IowaScaledEngineering/mrb-fcm/mech/frame/20130630_171943.jpg

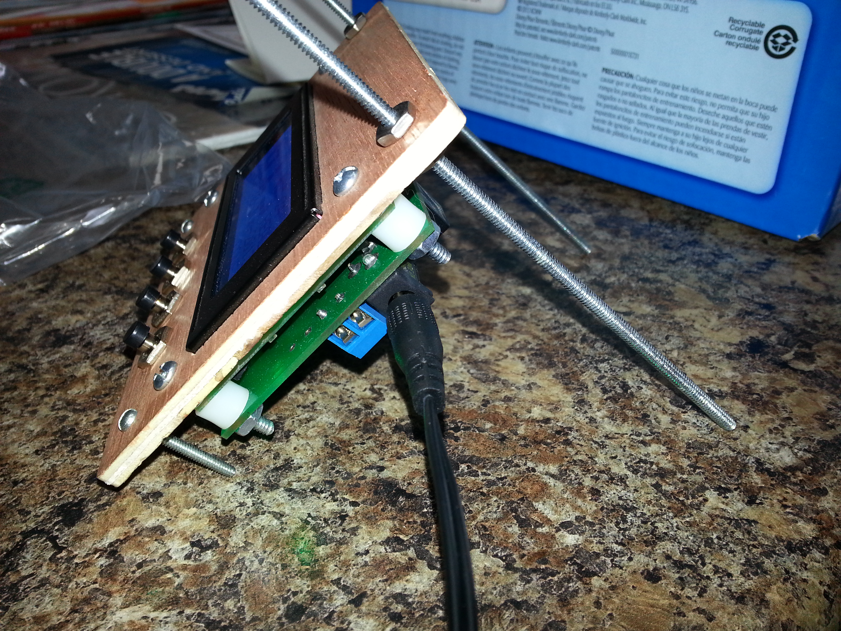
mech/frame/20130630_171943.jpg
