IowaScaledEngineering/mrb-fcm/doc/fastclock-bag-top-landscape.odt

Iowa Scaled Engineering, LLC

http://iascaled.com/

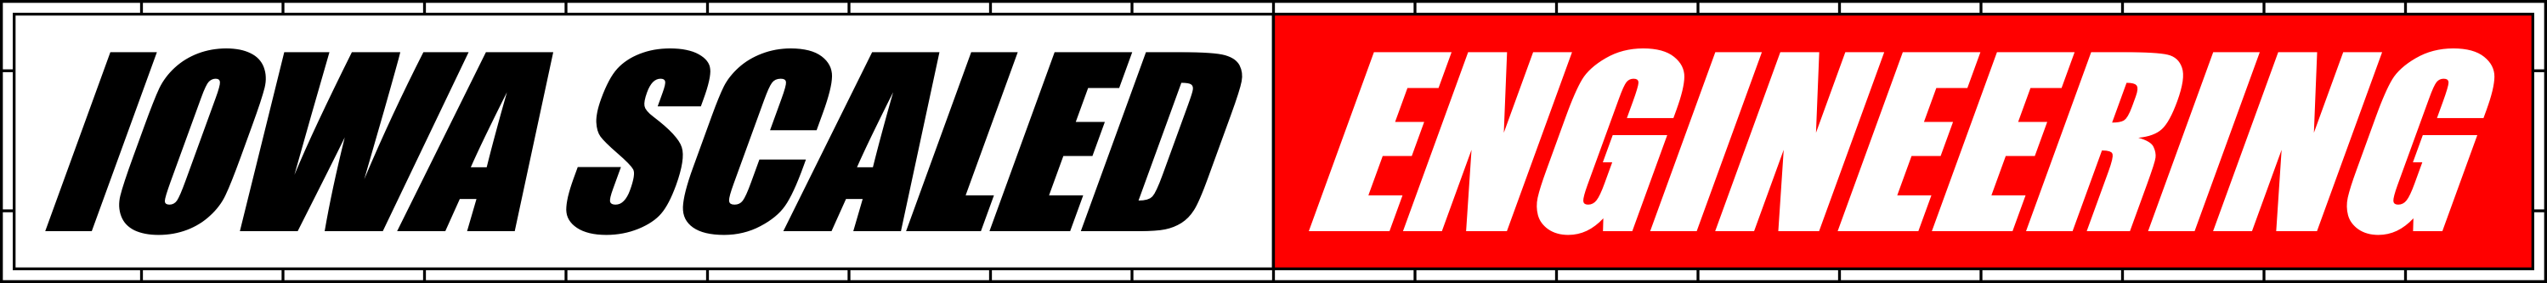
[picture p2: figure]

Fast Clock Master

Fast clock featuring fast time ratios from 1:1 to 99:1, three configurable start times, 12 or 24 hour display formats, "Hold" mode, unlimited remote displays, and real or fast time modes.

Wireless Version w/Extended-Range Radio

MRBW-FCM
