IowaScaledEngineering/mrb-fcm/doc/fastclock-bag-top.odt

Iowa Scaled Engineering, LLC

http://iascaled.com/

Iowa Scaled Engineering, LLC

http://iascaled.com/

Fast Clock Master

Fast clock featuring fast time ratios from 1:1 to 99:1, three configurable start times, 12 or 24 hour display formats, "Hold" mode, unlimited remote displays, and real or fast time modes.

Wireless Version

MRBW-FCM

Fast Clock Secondary Display

Fast time display shows the current fast or real time in multiple strategic locations around the layout room, all automatically synchronized to the master clock.

Wireless Version

MRBW-FCS

Fast Clock Master

Fast clock featuring fast time ratios from 1:1 to 99:1, three configurable start times, 12 or 24 hour display formats, "Hold" mode, unlimited remote displays, and real or fast time modes.

Wireless Version w/Extended-Range Radio

$138

STL RPM SALE!

Includes FREE face plate and power supply.

MRBW-FCM

Fast Clock Secondary Display

Fast time display shows the current fast or real time in multiple strategic locations around the layout room, all automatically synchronized to the master clock.

Wireless Version

$75

STL RPM SALE!

Includes FREE face plate and power supply.

MRBW-FCS
