IowaScaledEngineering/mrb-fcm/pg/mrb-fcm-sw-v1.0-r1073/mrb-fcm-sw-pcb.pdf

# mrb-fcm-sw.pcb

# 1. Table of Contents (This Page) Created on Mon May 26 17:38:17 2014

# 2. top 3. bottom 4. outline 5. plated-drill 6. componentmask 7. soldermask 8. topsilk 9. bottomsilk 10. topassembly 11. bottomassembly 12. fab

top, scale = 1:1.000 bottom (mirrored), scale = 1:1.000

outline, scale = 1:1.000 plated-drill, scale = 1:1.000

topmask, scale = 1:1.000 bottommask (mirrored), scale = 1:1.000

topsilk, scale = 1:1.000 bottomsilk (mirrored), scale = 1:1.000

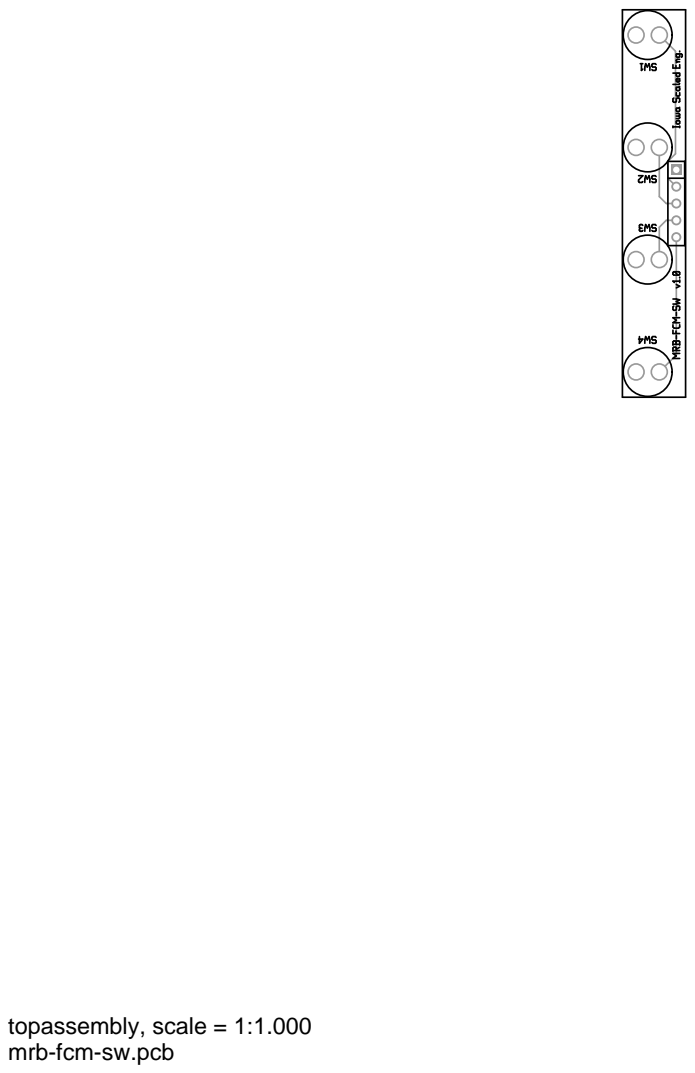
[picture p3: page 10]
topassembly, scale = 1:1.000

bottomassembly (mirrored), scale = 1:1.000

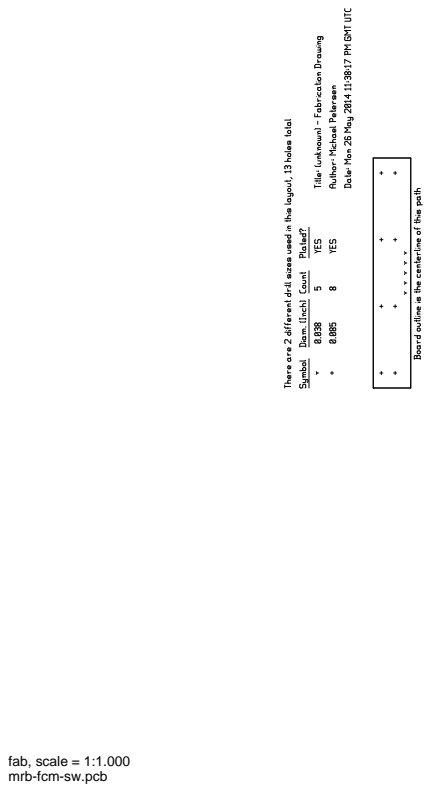
[picture p4: page 12]
fab, scale = 1:1.000
