IowaScaledEngineering/mrb-fcm/mech/faceplates/fcm-template.pdf

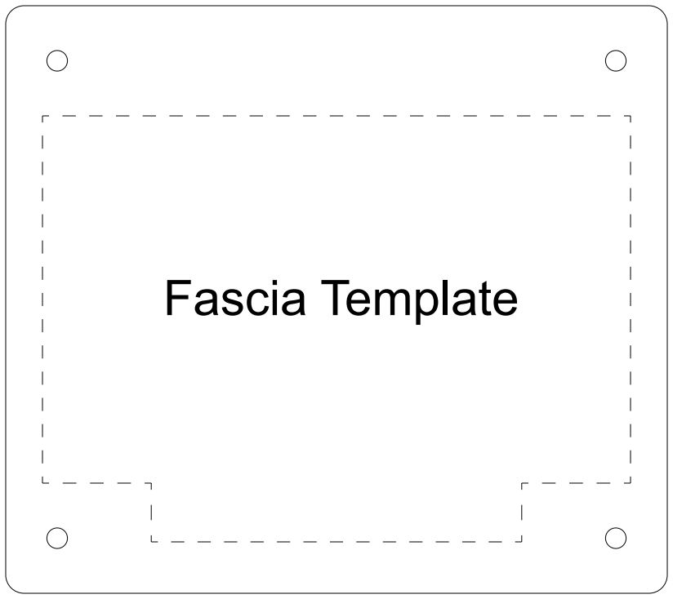
[picture p5: figure]
Fascia Template
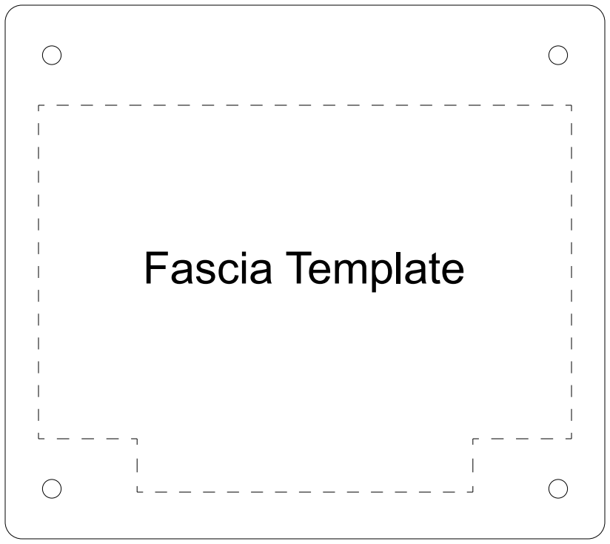
[picture p6: figure]
Fascia Template
