IowaScaledEngineering/mrb-fcm/doc/datasheets/erm2004-1_outline.jpg

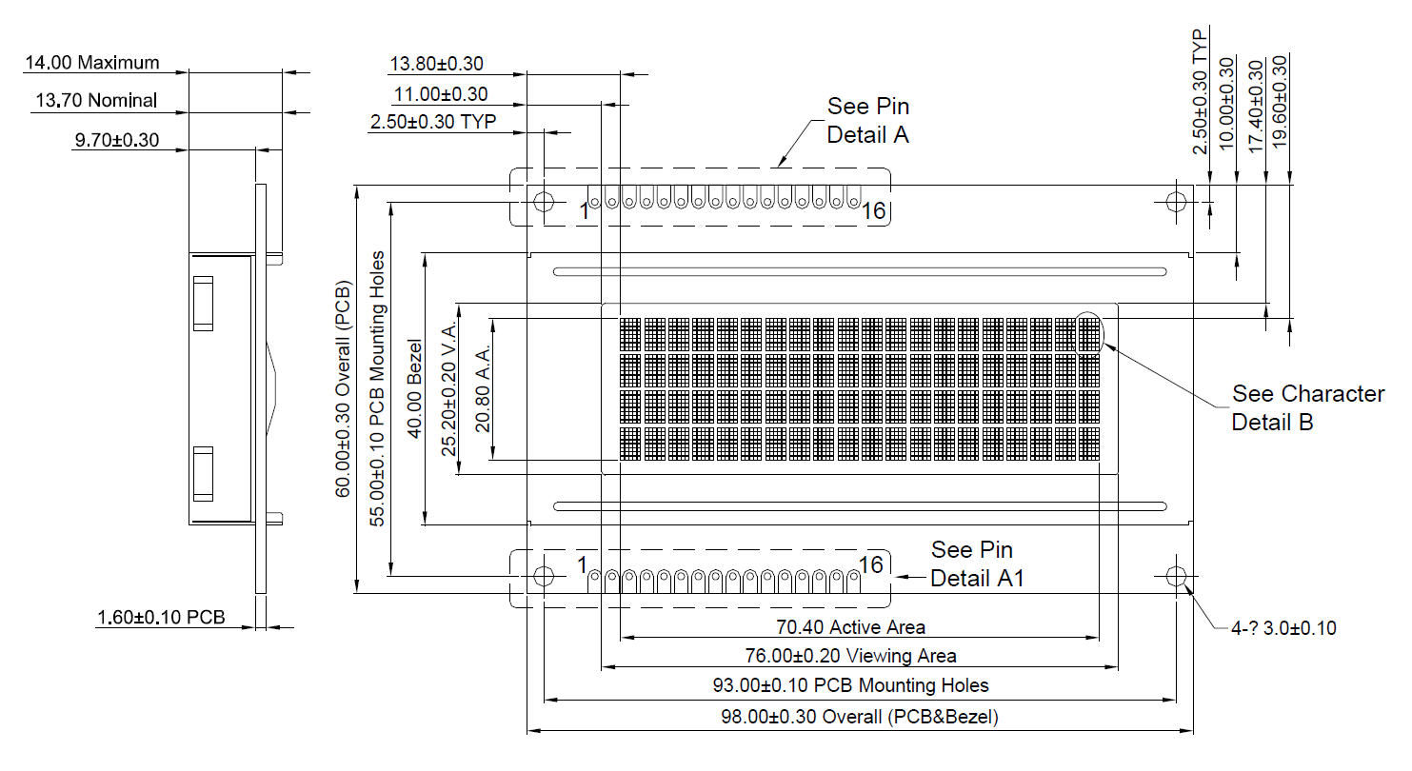
doc/datasheets/erm2004-1_outline.jpg
