IowaScaledEngineering/mrb-fcm/mech/box/fcm-box-open.stl

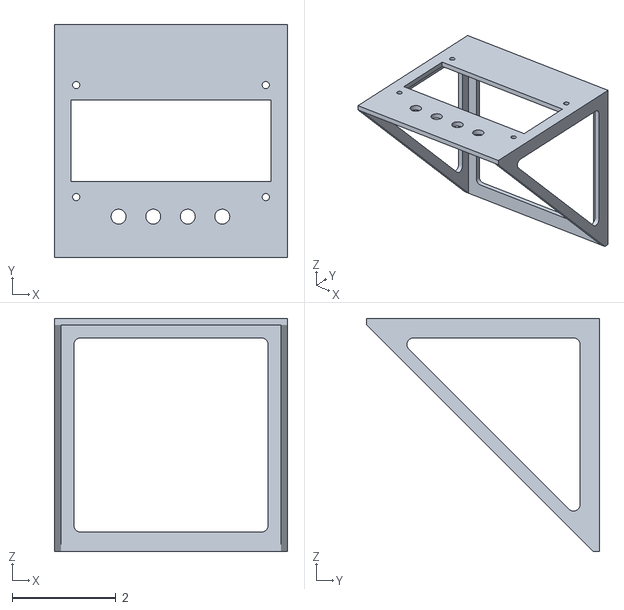
[picture p8: CAD file, 2013-11-04]
mech/box/fcm-box-open.stl
4.50 x 4.50 x 4.50
