IowaScaledEngineering/mrb-fcm/mech/faceplates/fcm-faceplate2-spacer.stl

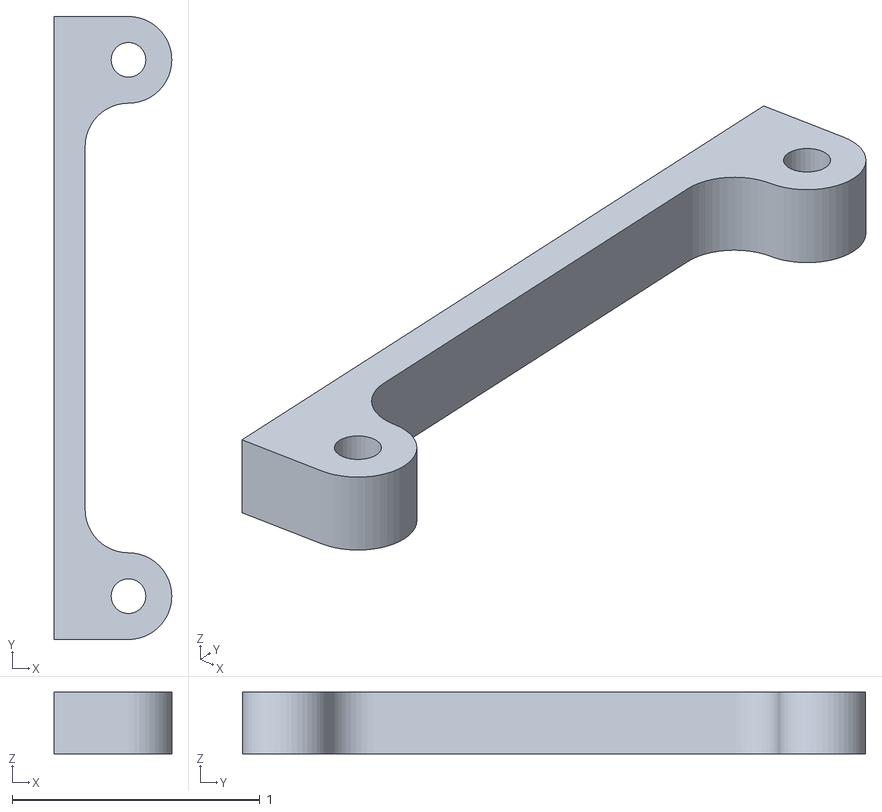
[picture p9: CAD file, 2026-06-20]
mech/faceplates/fcm-faceplate2-spacer.stl
0.475 x 2.52 x 0.25
