IowaScaledEngineering/mrb-fcm/mech/faceplates/v1/FCM Faceplate.stl

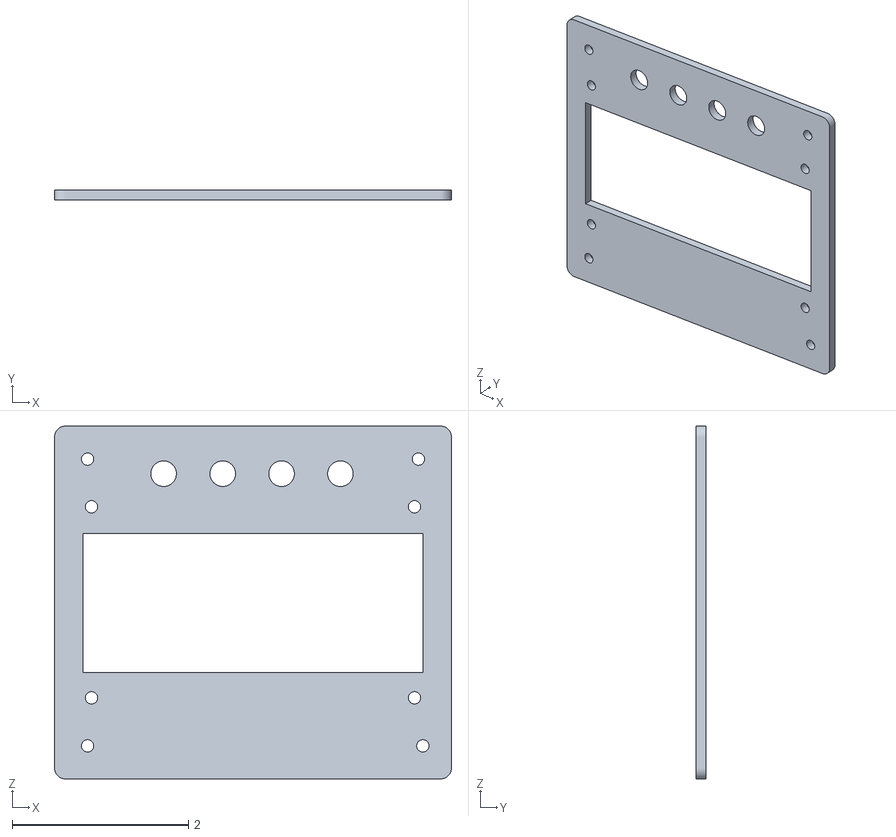
[picture p10: CAD file, 2019-03-28]
mech/faceplates/v1/FCM Faceplate.stl
4.50 x 0.118 x 4.00
