IowaScaledEngineering/mrb-fcm/mech/box/fcm-box.stl

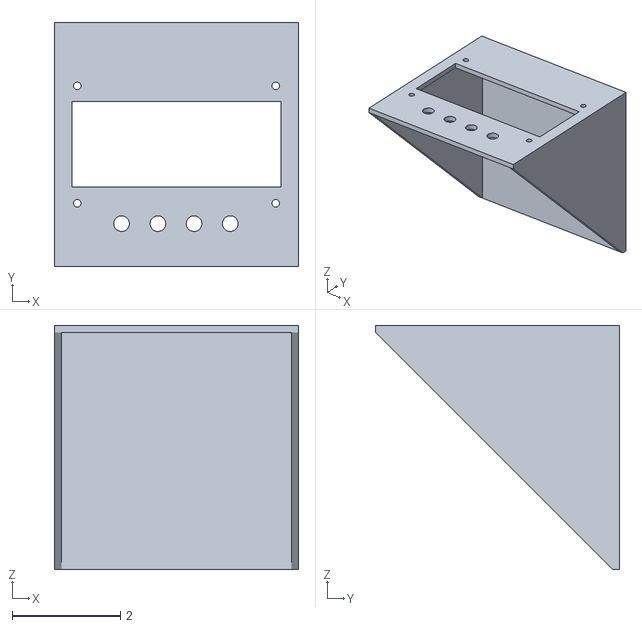
[picture p11: CAD file, 2013-11-04]
mech/box/fcm-box.stl
4.50 x 4.50 x 4.50
