IowaScaledEngineering/mrb-fcm/mech/faceplates/lcd-spacer.stl

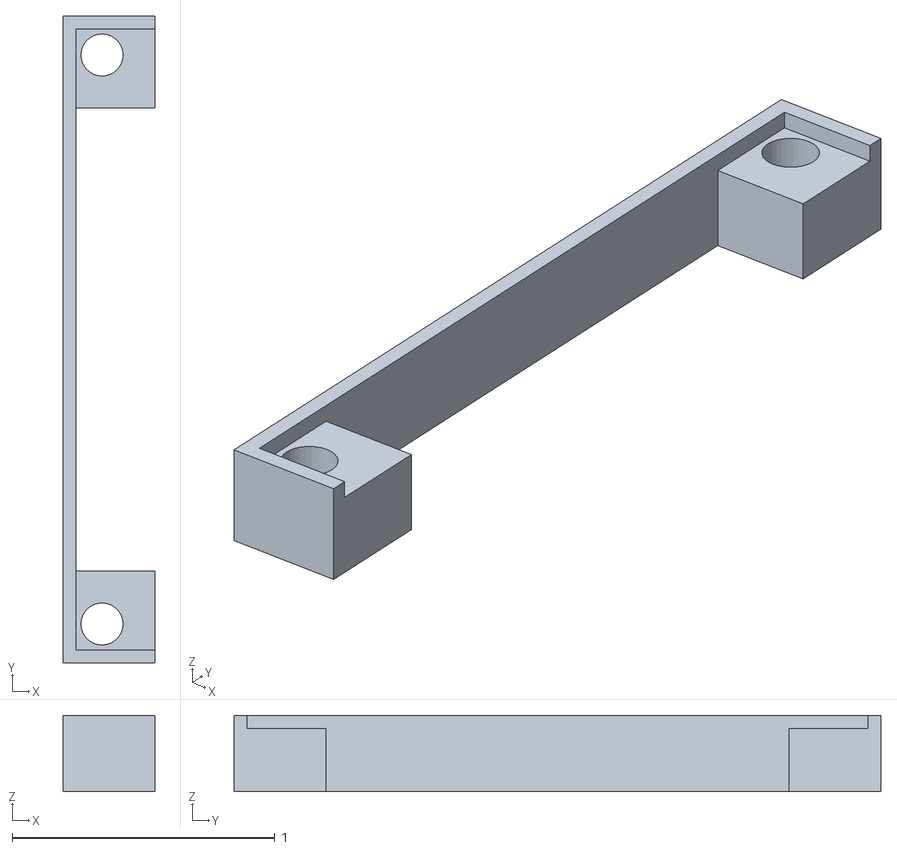
[picture p12: CAD file, 2026-06-20]
mech/faceplates/lcd-spacer.stl
0.35 x 2.46 x 0.29
