IowaScaledEngineering/mrb-fcm/mech/faceplates/v1/Display-Dimensions.dxf

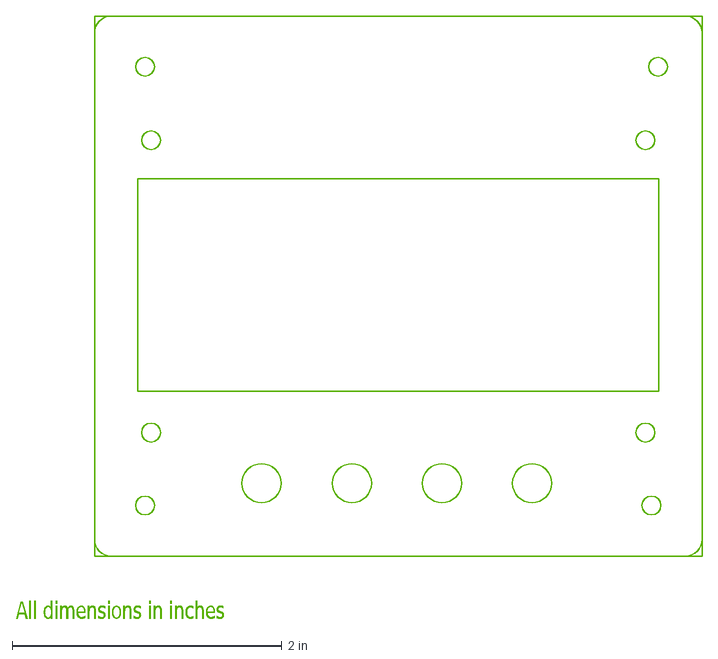
[picture p13: CAD file, 2014-01-10]
mech/faceplates/v1/Display-Dimensions.dxf
All dimensions in inches
