IowaScaledEngineering/mrb-fcm/mech/faceplates/fcm-faceplate v11.stl

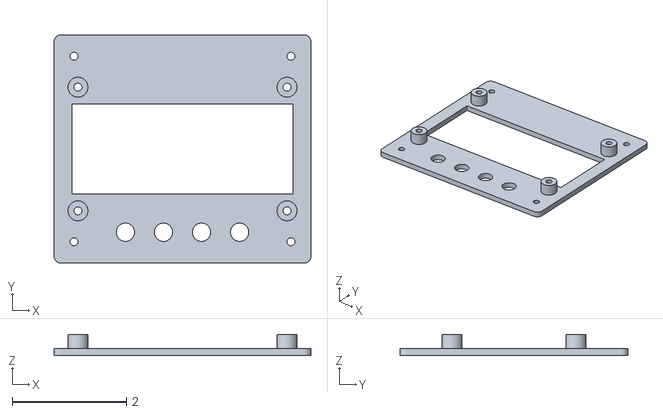
[picture p14: CAD file, 2021-11-19]
mech/faceplates/fcm-faceplate v11.stl
4.50 x 4.00 x 0.37
