IowaScaledEngineering/mrb-fcm/mech/faceplates/v1/Display.dxf

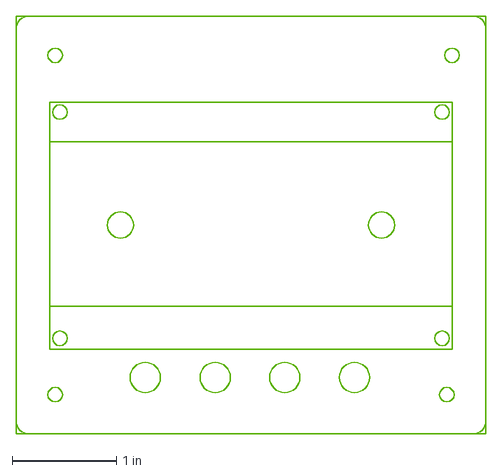
[picture p15: CAD file, 2014-01-10]
mech/faceplates/v1/Display.dxf
4.50 x 4.00 in
