IowaScaledEngineering/mrb-fcm/mech/faceplates/fcm-table-mount v6.stl

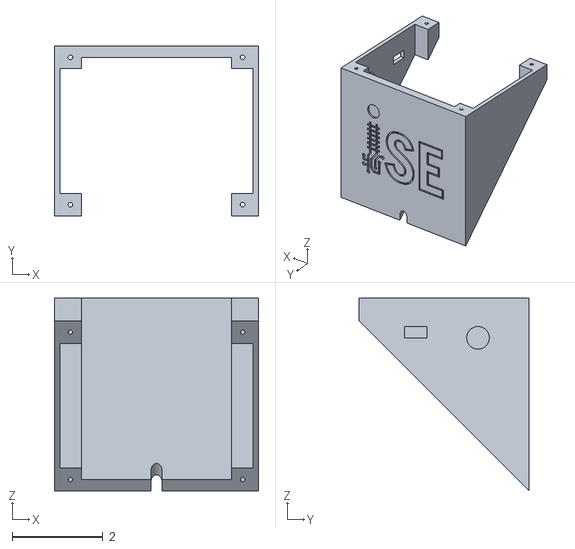
[picture p16: CAD file, 2021-07-27]
mech/faceplates/fcm-table-mount v6.stl
4.50 x 3.75 x 4.25
