IowaScaledEngineering/mrb-fcm/mech/faceplates/fcm-spacer v3.stl

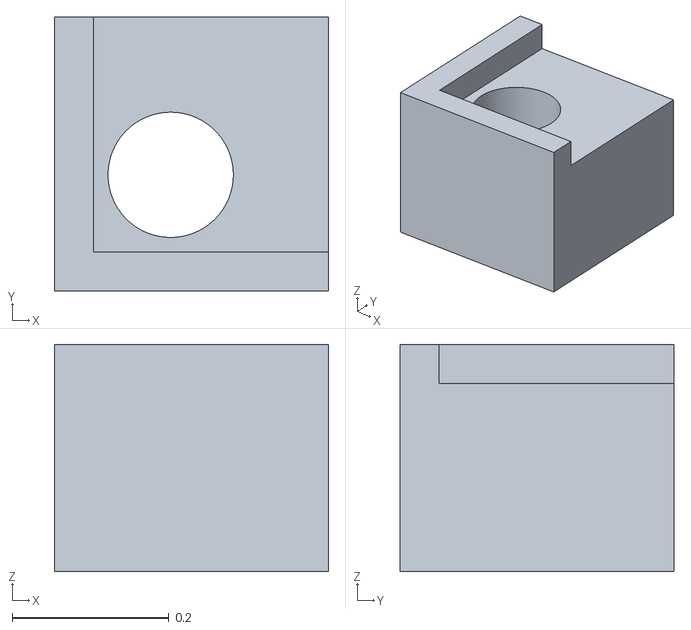
[picture p17: CAD file, 2020-11-19]
mech/faceplates/fcm-spacer v3.stl
0.35 x 0.35 x 0.29
