IowaScaledEngineering/mrb-fcm/(list of files, cad)

Other CAD files:
mech/box/fcm-box-open-repaired.stl
mech/box/fcm-box.scad
mech/faceplates/v1/FCM Faceplate.f3d
