IowaScaledEngineering/mrb-fcm/doc/fastclockmanual.odt

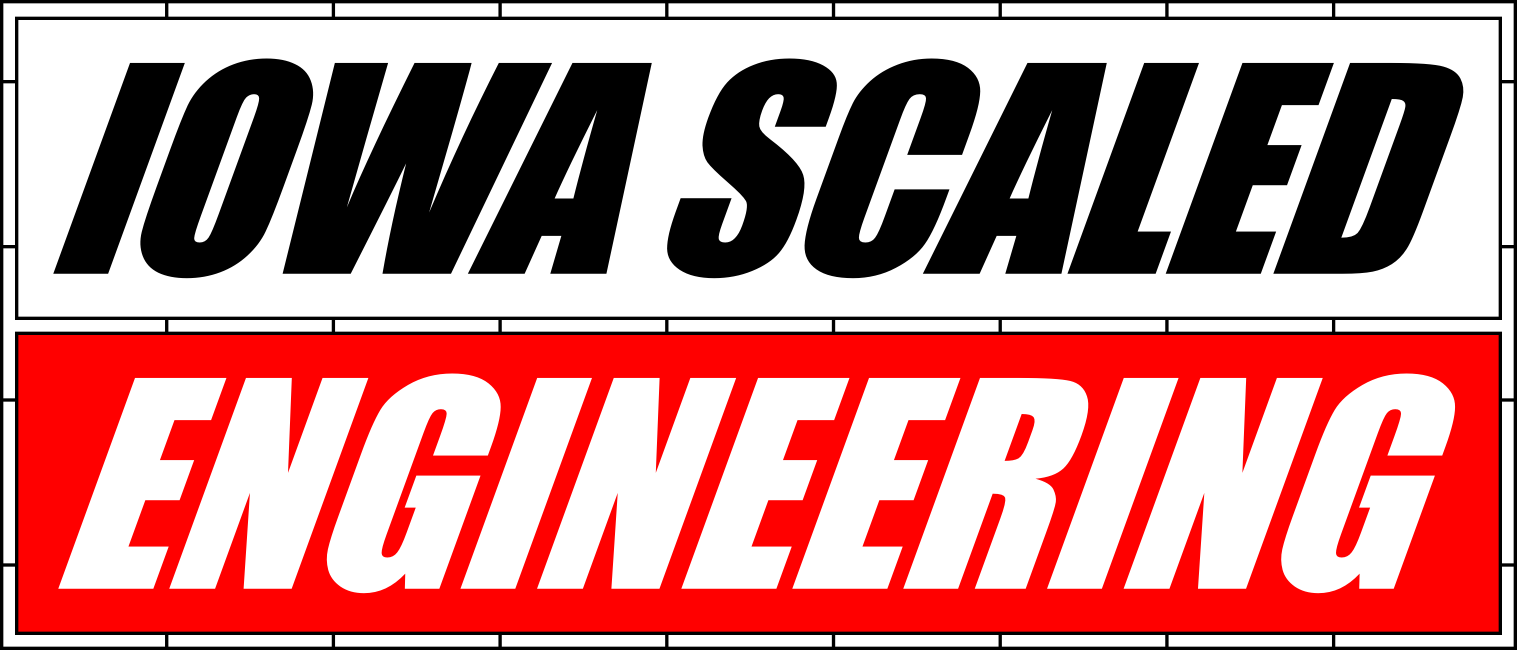
[picture p18: figure]

PaceSetter
Wireless Scale Time Clock

Instruction Manual

MRB-FCM v2.1

The PaceSetter is a configurable digital scale time clock designed to support timetable-based model railroad operations.

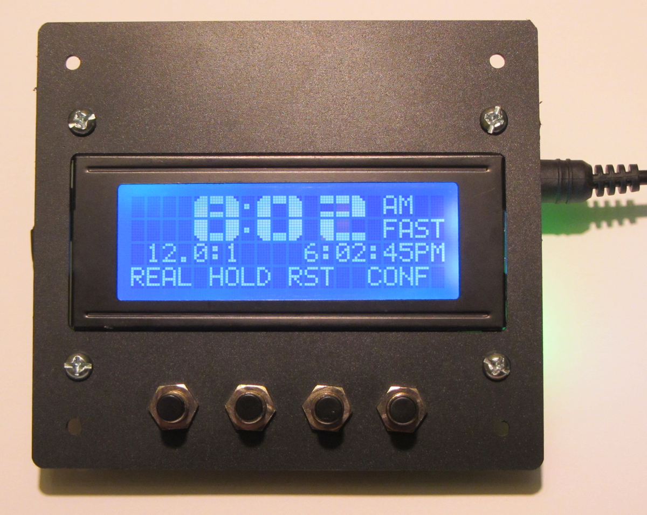
[picture p19: figure]
An MRB-FCM clock with optional faceplate and buttons, displaying fast time

## Key Features

- Scale time clock ratio adjustable between 0.1:1 and 99.9:1 for running faster or slower than real time
- “Hold” mode for pausing operations
- Switchable display between fast and real time
- Real-time clock/calendar with battery backup
- Three configurable fast clock start times
- 12 and 24 hour time display formats
- Compatible with wireless PaceSetter Remote Displays
- Compatible with the ProtoThrottle

## Kit Contents

- PaceSetter master fast clock
- 12V 1A power supply
- Faceplate (pre-installed)
- Manual and fascia cutting template

## Installation

The PaceSetter requires a stable 8-24V DC power supply capable of 0.3 amps. The kit includes a 12V power supply that can be plugged directly into J1A on the back, or if your layout has DC power already available, it can be connected to terminal block J1 instead.

The PaceSetter is designed to be mounted in the layout fascia. To help you accurately position and cut the necessary holes, we’ve included a template for the cutout.

## About “Fast” Time

The PaceSetter is a scale time clock, meaning that you can run “fast” time both faster or slower than real time. Most users will use it to run faster, meaning that several minutes of scale time will pass for each real minute (ratios greater than 1.0:1), but some users may also want to run slower, such that a scale minute takes 2-3 real minutes (ratios less than 1.0:1). It’s up to you. However, in the manual and the menus, this scaled time will be referred to as “fast” regardless.

## Initial Configuration

The PaceSetter comes from Iowa Scaled preprogrammed with reasonable defaults, so for many users the only initial configuration needed will be the current date and time, as well as fast clock parameters appropriate for your layout. All configuration is done using the CONF menu button at the bottom of the main screen.

Most users will want to start by setting the fast time ratio. Only you can determine what the proper fast clock ratio is for your layout, but as a suggestion, many operations want to simulate a 24-hour day within a 3-4 hour time period comprising an operating session. To figure out the ratio you want:

Ratio = (Scale Time) / (Real Time)

So, if you want to simulate 10 hours in the space of 3 hours, you'd come up with a ratio of 10/3 or 3.3. This is then set into the “Fast Clock Ratio” menu screen.

You will also likely want to set up start times that correspond to when your operating sessions typically begin, so that you can easily reset the fast clock at the beginning of the operating session. Up to three start times can be pre-programmed to be selectable when you press the “RST” (reset) key in fast time mode. If, for example, your operating day always begins at 8 AM, you might only program start time #1 to 08:00. If you run a scale 12 hours at each session, you might program both 06:00 and 18:00 as start times.

## Operation

The PaceSetter is always either in real time or scale time mode, indicated by “REAL” or “FAST” to the right of the time on the main screen. The leftmost soft key will toggle between the two modes. Any remote displays will follow whatever the master PaceSetter is displaying.

When in scale time mode, the middle two soft keys become active.

One will switch between “RUN”, meaning scale time will advance at the ratio set, and “HOLD” which pauses the advance of scale time. This is useful in operating sessions if your crew wants to take a break, or if you want to pause fast time at the current point until your next operating session. The current fast time will be preserved, even in the event of loss of power.

The other soft key that becomes active in scale time mode is “RST”. This allows you to reset scale time to one of the three pre-programmed values set up in the configuration menu.

## Optional Temperature/Humidity Monitor

The PaceSetter can be set up to monitor a remote temperature and humidity sensor, and display it alternating with the small date/time on the right side of line 3 on the main display. In order to read the sensor, the address of the remote sensor needs to be set in the “TH Address” menu option. Depending on how often the MRBW-TH is set to transmit, the timeout under “TH Timeout” may need to be adjusted so that the MRB-FCM doesn't stop displaying temperature and humidity readings.

## Battery Replacement

If the PaceSetter loses track of real or fast time when unplugged, the backup battery may have come loose or gone dead. Replace with a new CR1220 3V lithium coin cell.

## Open Design

Iowa Scaled Engineering is committed to creating open designs that users are free to build, modify, adapt, improve, and share with others.

### Hardware

The design of the MRB-FCM hardware is open source hardware, and is made available under the term of the Creative Commons Attribution-Share Alike v3.0 license (a copy of the license is available from http://creativecommons.org/licenses/by-sa/3.0/ )

Design files can be found on the Iowa Scaled Engineering website:

http://www.iascaled.com/store/MRB-FCM

### Firmware

The official Iowa Scaled Engineering firmware for the MRB-FCM is free software: you can redistribute it and/or modify it under the terms of the GNU General Public License as published by the Free Software Foundation, either version 3 of the License, or (at your option) any later version. A copy of the GNU GPL can be found at http://www.gnu.org/licenses/gpl.html

New firmware can be flashed into the MRB-FCM through J3, a standard 6-pin Atmel AVR ISP (in-system programming) header.

Stable releases of firmware and source code can be found on the Iowa Scaled Engineering website: http://www.iascaled.com/store/MRB-FCM

The latest firmware source can also be obtained from our Github archive. It can be found at you'll need both the mrb-fcm project and the mrbus/mrbee core library pieces. They can be obtained from:

Fast Clock Master:

https://github.com/IowaScaledEngineering/mrb-fcm

The Main Screen – Real Time Clock Mode

AM

REAL

FC:1200A 7 Jan 2021

FAST CONF

12:34

When the clock is in “real time” mode, the main screen will look like this.

Element | Description
12:34 | The current real time, in hour/minute form. If 24 hour real time is selected, this will display with the leading zero. If 12 hour real time is selected, the leading zero will be suppressed.
7 Jan 2021 | The current real day, month, and year.
FC:1200A | The current state of the fast clock. This will display FC: if the clock will immediately resume counting upon entry into Fast Clock Mode(FCM), and FH: if the clock will go into hold upon entering FCM.
AM | If 24 hour real time is selected, this will show “24”. In 12 hour real time mode, this will show AM or PM as appropriate.
REAL | An indicator that the clock is currently in Real Time Mode (RTM).
FAST | Soft key 1 will enter into Fast Clock Mode – see Screen 1.1
CONF | Soft key 4 will enter the Configuration Menu – see Screen 2.0

The Main Screen – Fast Clock Mode

AM

FAST

12.5:1 12:34:56AM

REAL HOLD RST CONF

12:34

When the clock is in “fast time” mode, the main screen will look like this.

Element | Description
12:34 | The current fast time, in hour/minute form. If 24 hour fast time is selected, this will display with the leading zero. If 12 hour fast time is selected, the leading zero will be suppressed. In hold mode, the display will show “HOLD”
12:34:56AM | The current real time, in hours/minutes/seconds and an AM/PM indicator if the real time clock is set up for 12 hour mode.
12.5:1 | The current fast time ratio, expressed in units of fast time that will pass during 1 unit of real time. (eg, 12.5 seconds will elapse for every real second in this example.)
REAL | Soft key 1 will enter into Real Time Clock Mode – see Screen 1.0
HOLD | Soft key 2 will toggle between the fast clock time advancing at the programmed ratio and the fast clock being paused - “hold” mode. If the clock is running, it will display “HOLD”, and if the clock is paused, it will display “RUN”, reflecting the mode it will toggle into.
RST | Soft key 3 will reset the fast clock to the configured start time. See “Fast Clock Reset Screen"
CONF | Soft key 4 will enter the Configuration Menu – see “Configuration Menu”

Fast Clock Reset Screen

!! CONFIRM !!

Reset Fast Clock

to Which Start Time?

0800 1200 1800 CNCL

This screen allows you to reset the current fast time to one of the pre-programmed options. Times will always be shown in 24-hour format. For configuring each start time, see “Configuration: Fast Start Time”. Cancel will return to the Fast Clock main screen without affecting the current fast time.

Configuration Options Menu

> Real 12/24

Real Time

Real Date

UP DOWN SLCT BACK

From this menu, you can configure all of the options within your PaceSetter clock to fit your layout’s unique needs. Using the UP / DOWN soft keys, you can move up and down through multiple pages of options. SLCT will go into the configuration menu for the option the cursor is currently pointing at, and BACK will return you to the main screen

Configuration options:

- Real 12/24 - Configure whether real time is displayed in 12 or 24 hour format
- Real Time – Set the real time
- Real Date – Set the real date
- Fast 12/24 - Configure whether fast time is displayed in 12 or 24 hour format
- Fast Ratio – Configure how “fast” fast time is in relation to real time
- Fast Start Hold – Configure if fast time always starts out in hold, or immediately starts moving forward
- Fast Start Time 1/2/3 – Configure the pre-selected times that the fast clock can be reset to using the “RST” option on the main fast time screen.
- Time Pkt Interval – Configure how often a time packet is sent over the wireless network
- Clock Address – Configure the PaceSetter’s wireless network addresses
- TH Address – Configure the address of the optional wireless temperature/humidity sensor
- TH Timeout – Configure how often the clock expects to see the optional temperature/humidity sensor
- Temperature Units – Configure whether temperature is displayed in Fahrenheit or Celsius
- Diagnostics – Some basic diagnostics to verify unit operation
- Factory Reset – Reset the clock to factory defaults

Configuration: Real Time 12/24h

Real Time 12/24H:

[*] 12H (AM/PM)

[ ] 24H (0000h)

12hr 24hr SAVE CNCL

Element | Description
* | Indicates the current selected option
12H (AM/PM) | Configure real time to be displayed in 12 hour, AM/PM time.
24H (0000h) | Configure real time to be displayed in 24 hour time.
12hr | Soft key 1 – selects 12 hour time display
24hr | Soft key 2 – selects 24 hour time display
SAVE | Soft key 3 – saves real time format selection and returns to the Configuration Menu
CNCL | Soft key 4 – returns to Configuration Menu without changing how real time is displayed

Configuration: Set the Real Time

Current Real Time:

12:34:56 AM

^^

++ -- >> GO

Element | Description
12:34:56 | The current real time, displayed as 12 or 24 hour time as selected in screen 2.1. (In 24h time, the AM/PM indicator will not display. In 12h mode, AM/PM cannot be directly adjusted, but advancing the hours over midnight or noon will cause the transition.)
^^ | A cursor indicating which part of real time is subject to adjustment by soft keys 1 and 2.
++ | Soft key 1 – increments the currently selected part of the time.
-- | Soft key 2 – decrements the currently selected part of the time.
>> | Soft key 3 – moves the cursor to the next component of time to the right (hours move to minutes move to seconds, which then wraps around to hours)
GO | Soft key 4 – advances to the confirmation screen

Confirmation

Current Real Time:

12:34:56 AM

BACK SAVE CNCL

Element | Description
12:34:56 | The current real time to be set as configured in screen 2.2, displayed as 12 or 24 hour time as selected in screen 2.1. (In 24h time, the AM/PM indicator will not display.)
BACK | Soft key 1 – returns to screen 2.2, so that the real time to be set can be changed.
SAVE | Soft key 3 – saves the displayed real time to the internal real time clock.
CNCL | Soft key 4 – cancels changing the real time and returns to the Configuration Menu

Configuration: Set the Real Date

Current Real Date:

11 Nov 2012

^^

++ -- >> GO

Element | Description
^^ | A cursor indicating which part of real time clock date is subject to adjustment by soft keys 1 and 2.
11 Nov 2012 | The current real date
++ | Soft key 1 – increments the currently selected part of the date.
-- | Soft key 2 – decrements the currently selected part of the date.
>> | Soft key 3 – moves the cursor to the next component of date to the right (day moves to month moves to year, which then wraps around to day)
GO | Soft key 4 – advances to the confirmation screen

Confirmation Screen

Current Real Date:

11 Nov 2021

BACK SAVE CNCL

Element | Description
11 Nov 2021 | The current date to be set
BACK | Soft key 1 – returns to previous screen to change the date
SAVE | Soft key 3 – saves the displayed date to onboard real time clock
CNCL | Soft key 4 – cancels changing the date and returns to the main configuration menu.

Configuration: Fast Time 12/24h Selection

Fast Time 12/24H:

[*] 12H (AM/PM)

[ ] 24H (0000h)

12hr 24hr SAVE CNCL

Element | Description
* | A cursor indicating the current selection
12H (AM/PM) | Configure fast time to be displayed in 12 hour, AM/PM time.
24H (0000h) | Configure fast time to be displayed in 24 hour time.
12hr | Soft key 1 – selects 12 hour time.
24hr | Soft key 2 – selects 24 hour time.
SAVE | Soft key 3 – saves fast time format selection and returns to configuration screen 2.0b.
CNCL | Soft key 4 – returns to configuration screen 2.0b without saving fast time format change.

Configuration: Fast Clock Ratio

Fast Clock Ratio:

12.5:1

^^

++ -- >> GO

Element | Description
12.5:1 | The ratio between how quickly fast time passes and how quickly real time passes. As an example, 4.0:1 would yield the passage of 24 hours of fast time in 6 hours. Additionally, the clock can run slower than real time as well. Setting the value to less than 1.0:1 will result in a “fast” clock that runs slower than real time.
^^ | A cursor indicating which part of the ratio is subject to adjustment by soft keys 1 and 2.
++ | Soft key 1 – increments the currently selected part of the ratio.
-- | Soft key 2 – decrements the currently selected part of the ratio.
>> | Soft key 3 – moves the cursor to the next component of the ratio to the right (integer portion or tenths), or wraps around if already on tenths.
GO | Soft key 4 – advances to screen 2.8 which confirms the ratio being set

Confirmation Screen

Fast Clock Ratio:

12.5:1

BACK SAVE CNCL

Element | Description
12.5:1 | The ratio between fast time and real time as selected in screen 2.7.
BACK | Soft key 1 – returns to screen 2.7, so that the fast clock ratio to be set can be changed.
SAVE | Soft key 3 – saves the displayed fast clock ratio to configuration memory
CNCL | Soft key 4 – cancels changing the fast clock ratio and returns to the main configuration menu (screen 2.0b).

Configuration: Fast Time Start Set

Fast Start Time X:

12:34:56 AM

^^

++ -- >> GO

Element | Description
Fast Start Time X: | X will be 1, 2, or 3, corresponding to which fast clock starting time is being set. See screen 1.2 for where fast clock start times can be selected during a reset, and screen 2.0c for how each start time configuration is reached.
12:34:56 | The desired start time for the fast clock, displayed as 12 or 24 hour time as selected in screen 2.6. (In 24h time, the AM/PM indicator will not display. In 12h mode, AM/PM cannot be directly adjusted, but advancing the hours over midnight or noon will cause the transition.)
^^ | A cursor indicating which part of fast start time is subject to adjustment by soft keys 1 and 2.
++ | Soft key 1 – increments the currently selected part of the time.
-- | Soft key 2 – decrements the currently selected part of the time.
>> | Soft key 3 – moves the cursor to the next component of time to the right (hours move to minutes move to seconds, which then wraps around to hours)
GO | Soft key 4 – advances to screen 2.10 which confirms the fast start time being set.

Confirmation Screen

Fast Start Time X:

12:34:56 AM

BACK SAVE CNCL

Element | Description
Fast Start Time X: | X will be 1, 2, or 3, corresponding to which fast clock starting time is being set. See screen 1.2 for where fast clock start times can be selected during a reset, and screen 2.0c for how each start time configuration is reached.
12:34:56 | The fast clock start time to be set as configured in screen 2.6, displayed as 12 or 24 hour time as selected in screen 2.6. (In 24h time, the AM/PM indicator will not display.)
BACK | Soft key 1 – returns to screen 2.9, so that the fast clock start time to be set can be changed.
SAVE | Soft key 3 – saves the displayed fast clock start time to configuration memory
CNCL | Soft key 4 – cancels changing the fast clock start time and returns to the main configuration menu (screen 2.0b).

Configuration Screen

Fast Start Mode:

[*] RUN (12:34A)

[ ] HOLD

RUN HOLD SAVE CNCL

Element | Description
* | A cursor indicating the current selection
[ ] RUN | Configure fast time to start counting immediately when fast clock mode is entered. As a convenience, the configured fast clock starting time is shown after “Run”.
[ ] HOLD | Configure fast time to immediately go to “hold” when fast clock mode is entered.
RUN | Soft key 1 – selects run mode.
HOLD | Soft key 2 – selects hold mode.
SAVE | Soft key 3 – saves fast time run/hold mode selection and returns to configuration screen 2.0c.
CNCL | Soft key 4 – returns to configuration screen 2.0c without saving fast time run/hold mode change.

Configuration: Time Packet Interval

Time Pkt Interval:

001.2 sec

^

++ -- >> GO

Element | Description
001.2 sec | The desired time between broadcasting time packets on the network, expressed in seconds. For most applications, 1-3 seconds is probably optimal (meaning a setting of 1.0-3.0).
^^ | A cursor indicating which digit of the time is subject to adjustment by soft keys 1 and 2.
++ | Soft key 1 – increments the currently selected part of the time.
-- | Soft key 2 – decrements the currently selected part of the time.
>> | Soft key 3 – moves the cursor to the next component of time to the right, or will wrap back around if already on the rightmost digit
GO | Soft key 4 – advances to screen 2.13 which confirms the packet interval time being set.

Confirmation Screen

Time Pkt Interval:

001.2 sec

BACK SAVE CNCL

Element | Description
001.2 sec | The desired time between broadcasting time packets on the network, expressed in seconds. For most applications, 1-3 seconds is probably optimal (meaning a setting of 1.0-3.0).
BACK | Soft key 1 – returns to screen 2.12, so that the fast clock start time to be set can be changed.
SAVE | Soft key 3 – saves the displayed fast clock start time to configuration memory and returns to the main configuration menu (screen 2.0c)
CNCL | Soft key 4 – cancels changing the fast clock start time and returns to the main configuration menu (screen 2.0c).

Configuration: PaceSetter Master Clock Network Address

Fast Clock Addr:

0x1A

^

++ -- >> GO

Element | Description
0x1A | The hexadecimal network address of the fast clock master node. All MRBus nodes must have a unique address. For pure fast clock applications, changing this should not be needed.
^^ | A cursor indicating which digit of the address is subject to adjustment by soft keys 1 and 2.
++ | Soft key 1 – increments the currently selected part of the address.
-- | Soft key 2 – decrements the currently selected part of the address.
>> | Soft key 3 – moves the cursor to the next digit of address to the right
GO | Soft key 4 – advances to screen 2.15 which confirms the network address.

Confirmation Screen

Fast Clock Addr:

0x1A

BACK SAVE CNCL

Element | Description
0x1A | The hexadecimal network address of the fast clock master node to be set.
BACK | Soft key 1 – returns to screen 2.14, so that the node address to be set can be changed.
SAVE | Soft key 3 – saves the displayed fast clock node address to configuration memory and returns to the main configuration menu (screen 2.0c)
CNCL | Soft key 4 – cancels changing the fast clock node address and returns to the main configuration menu (screen 2.0c).

Configuration: Diagnostics Screen

DIAG 0x03 78F 32kl

TH:None [-----]

8A1ACF v2.0

BACK

Element | Description
0x03 | The current network address of the PaceSetter master clock
78F | The temperature of the master clock, as measured by the real time clock on the PCB
32kl | The speed at which the main loop is executing, in thousands of loops per second. This is almost meaningless to an end user, but is handy for debugging slow reponse problems.
TH:3.2V | If an optional temperature/humidity monitor is configured and the fast clock has received a packet within the timout period, the supply voltage for the sensor will be displayed here. This is useful for checking the battery voltage on wireless, battery powered temperature/humidity nodes.
[-----] | Shows the status of all of the input lines
BACK | Soft key 4 – returns to the Configuration Menu

Configuration: Temperature/Humidity Node Address

Temp/Humidity Addr:

0x20

^

++ -- >> GO

Element | Description
0x20 | The MRBus address of the MRBW-TH node to be monitored. Setting this to 0x00 will cause the display to show “”T/H Off” and disable any display of temperature and humidity.
^ | A cursor indicating which digit of the address is subject to adjustment by soft keys 1 and 2.
++ | Soft key 1 – increments the currently selected part of the address.
-- | Soft key 2 – decrements the currently selected part of the address.
>> | Soft key 3 – moves the cursor to the next component of time to the right, or will wrap back around if already on the rightmost digit
GO | Soft key 4 – advances to screen 2.18 which confirms the TH address to be monitored.

Confirmation Screen

Temp/Humidity Addr:

0x20

BACK SAVE CNCL

Element | Description
0x20 | The MRBus address of the MRBW-TH node to be monitored. Setting this to 0x00 will cause the display to show “”T/H Off” and disable any display of temperature and humidity.
BACK | Soft key 1 – returns to screen 2.17, so that the MRBW-TH source address can be changed.
SAVE | Soft key 3 – saves the displayed temperature/humidity source address to configuration memory and returns to the main configuration menu (screen 2.0d)
CNCL | Soft key 4 – cancels changing the temperature/humidity source address and returns to the main configuration menu (screen 2.0d).

Configuration: Temperature/Humidity Timeout

Temp/Hum Timeout:

0012 sec

^

++ -- >> GO

Element | Description
0012 sec | The maximum amount of allowed time between received packets from the configured MRBW-TH temperature/humidity sensor. If a valid data packet from the TH node is not configured within this interval, the fast clock will stop displaying temperature/humidity until another packet is received.
^ | A cursor indicating which digit of the time is subject to adjustment by soft keys 1 and 2.
++ | Soft key 1 – increments the currently selected part of the time.
-- | Soft key 2 – decrements the currently selected part of the time.
>> | Soft key 3 – moves the cursor to the next component of time to the right, or will wrap back around if already on the rightmost digit
GO | Soft key 4 – advances to screen 2.20 which confirms the timeout being set.

Confirmation Screen

Temp/Hum Timeout:

0012 sec

BACK SAVE CNCL

Element | Description
0012 sec | The maximum amount of allowed time between received packets from the configured MRBW-TH node. If a valid 'S' packet from the TH node is not configured within this interval, the fast clock will stop displaying temperature/humidity until another packet is received.
BACK | Soft key 1 – returns to screen 2.19, so that the temperature/humidity packet time to be set can be changed.
SAVE | Soft key 3 – saves the displayed temperature/humidity timeout to configuration memory and returns to the main configuration menu (screen 2.0e)
CNCL | Soft key 4 – cancels changing the temperature/humidity timeout and returns to the main configuration menu (screen 2.0e).

Screen 2.21: Temperature Units Configuration Screen

Temperature Units:

[*] Degrees F

[ ] Degrees C

F C SAVE CNCL

Element | Description
* | A cursor indicating the current selection
Degrees F | Configure temperature to be displayed in degrees Fahrenheit
Degrees C | Configure temperature to be displayed in degrees Celsius
F | Soft key 1 – selects degrees Fahrenheit
C | Soft key 2 – selects degrees Celsius
SAVE | Soft key 3 – saves temperature unit selection and returns to configuration menu
CNCL | Soft key 4 – returns to configuration menu without saving any changes
