IowaScaledEngineering/mrb-fcm/(threads)

Thread 3 (2016-09-29):

Replace R9-R12 with a quad resistor pack

petersenm, 2016-09-29:

Closed 2020-09-30.

Thread 22 (2018-10-08):

Bring I2C lines out to (optional) Qwiic connector

petersenm, 2018-10-08:
Make a good display for data acquisition applications.  Change U4 CE from PC5 to PB5?  Or was that not done originally to prevent activating the RTC during programming?

Closed 2020-09-30.
