IowaScaledEngineering/mrb-fcm/pg/mrb-fcm-v2.1-87ef264/mrb-fcm.pdf

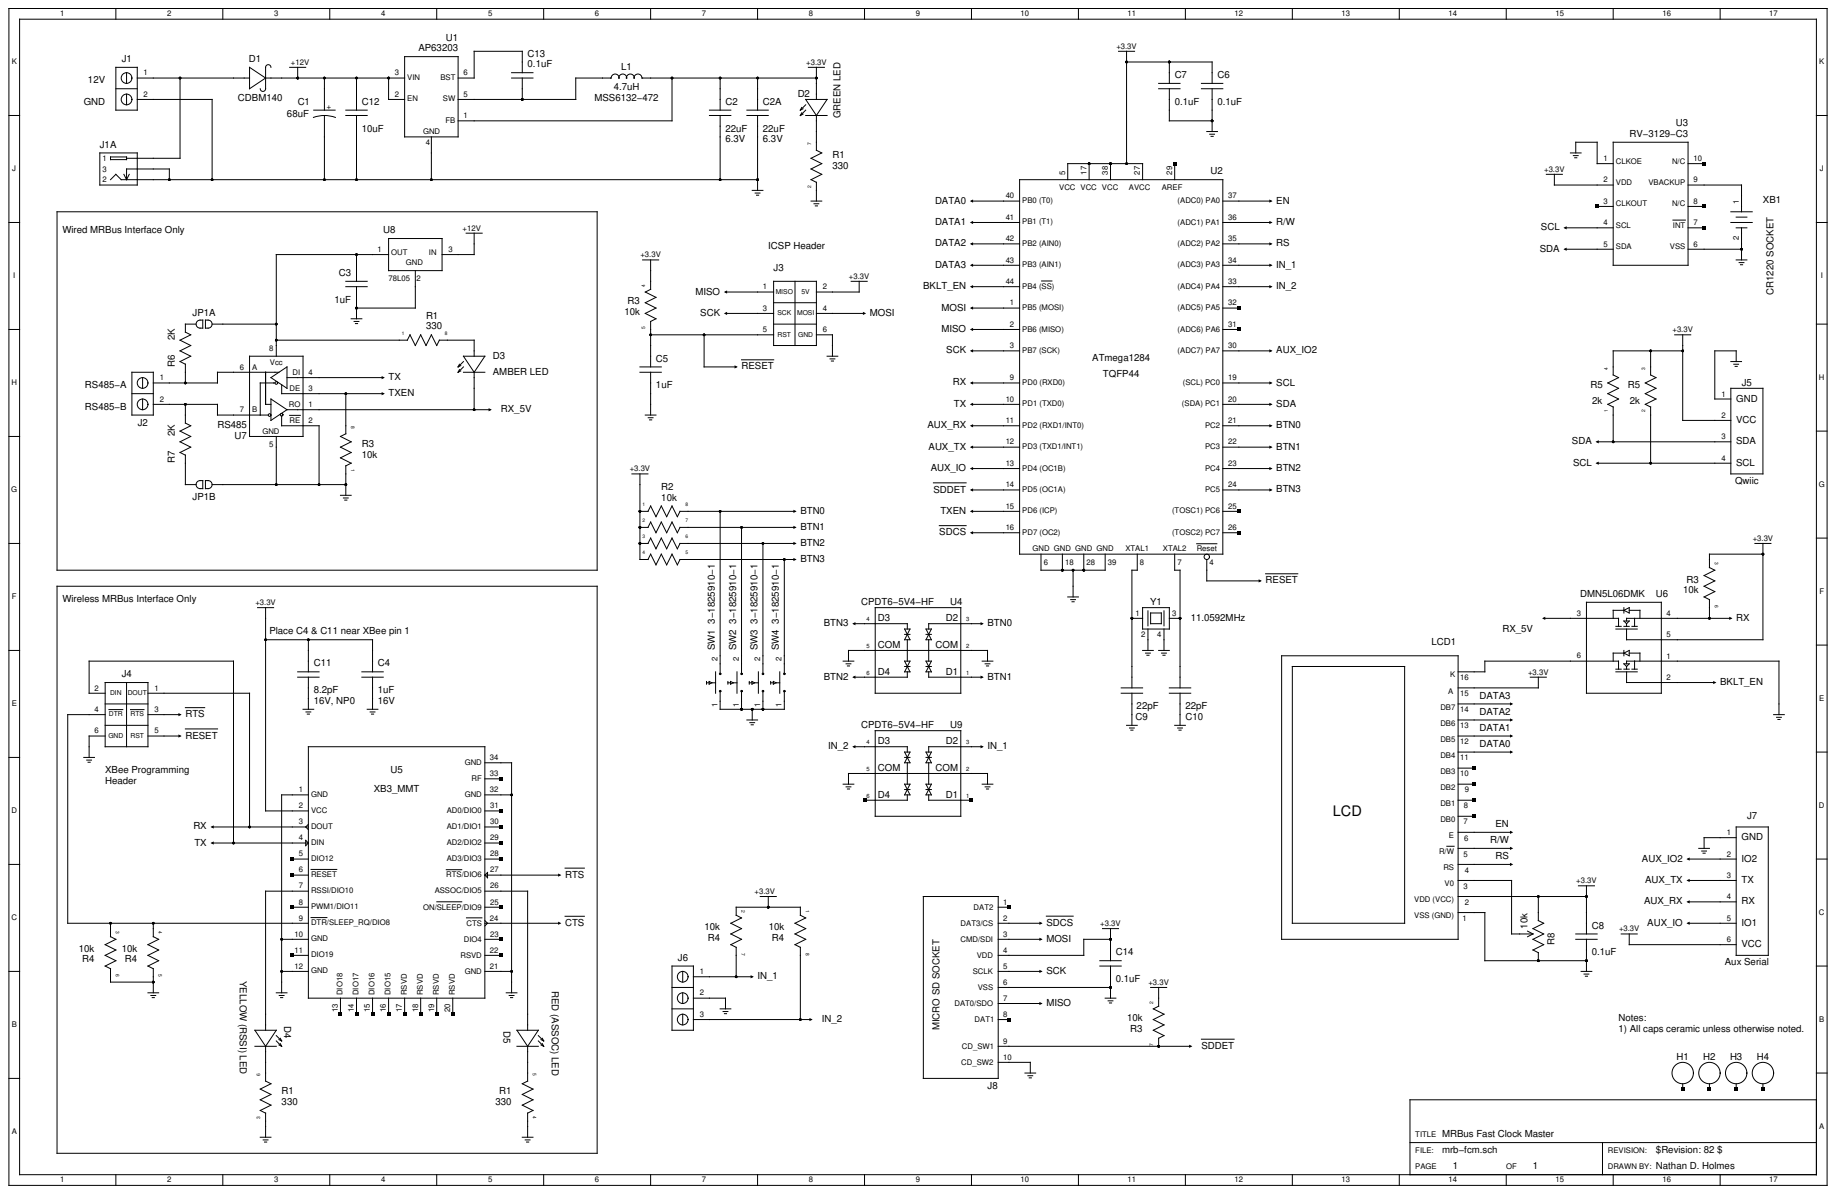
[picture p30: page 1]

Wired MRBus Interface Only

MISO | 5V

Wireless MRBus Interface Only

Place C4 & C11 near XBee pin 1

Notes:
1) All caps ceramic unless otherwise noted.

MRBus Fast Clock Master
mrb−fcm.sch
