IowaScaledEngineering/mrb-fcm/pg/mrb-fcm-v1.1-r688/mrb-fcm-pcb.pdf

# mrb-fcm.pcb

# 1. Table of Contents (This Page) Created on Mon Feb 4 20:14:34 2013

# 2. component 3. solder 4. plated-drill 5. componentmask 6. soldermask 7. topsilk 8. bottomsilk 9. toppaste 10. topassembly 11. bottomassembly 12. fab

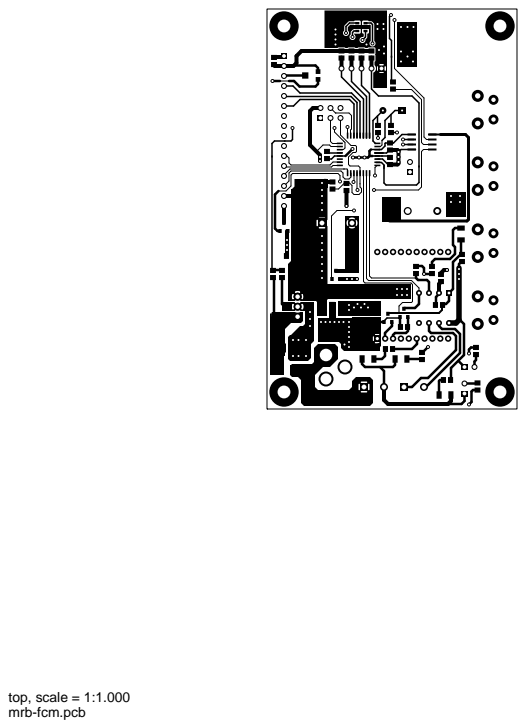
[picture p31: page 2]
top, scale = 1:1.000

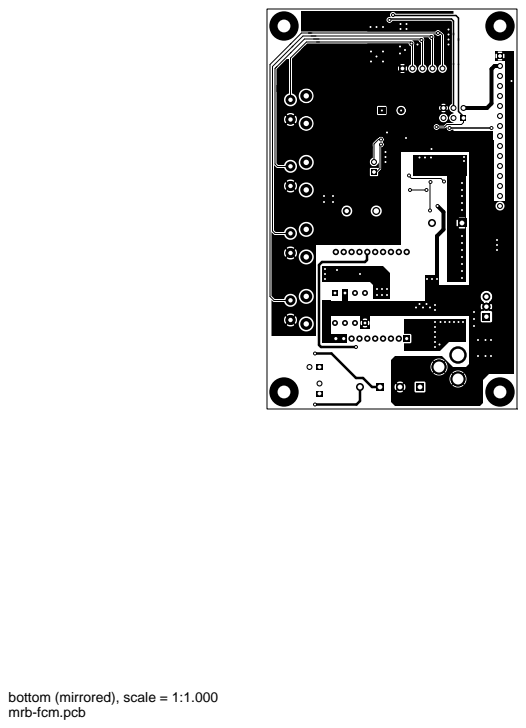
[picture p32: page 3]

bottom (mirrored), scale = 1:1.000

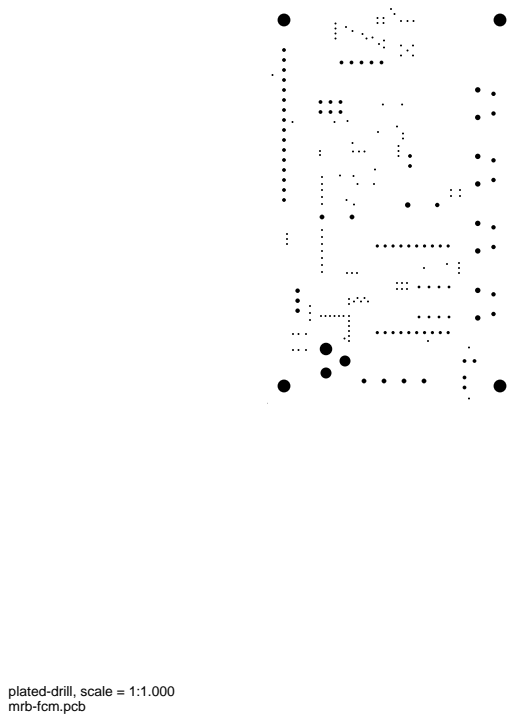
[picture p33: page 4]

plated-drill, scale = 1:1.000

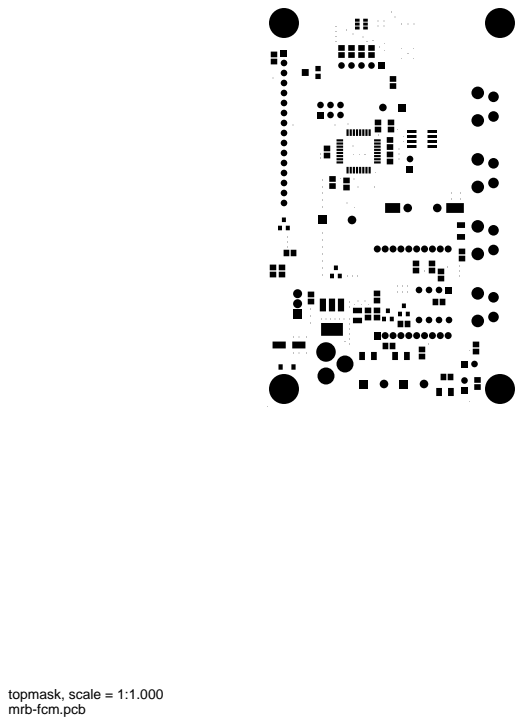
[picture p34: page 5]
topmask, scale = 1:1.000

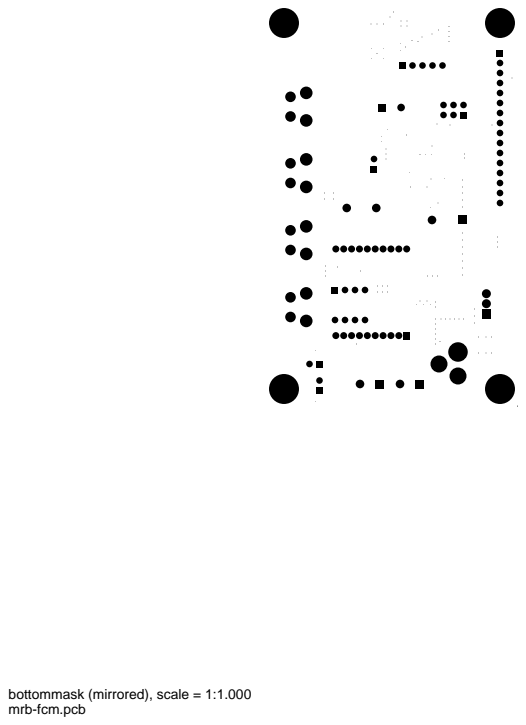
[picture p35: page 6]

bottommask (mirrored), scale = 1:1.000

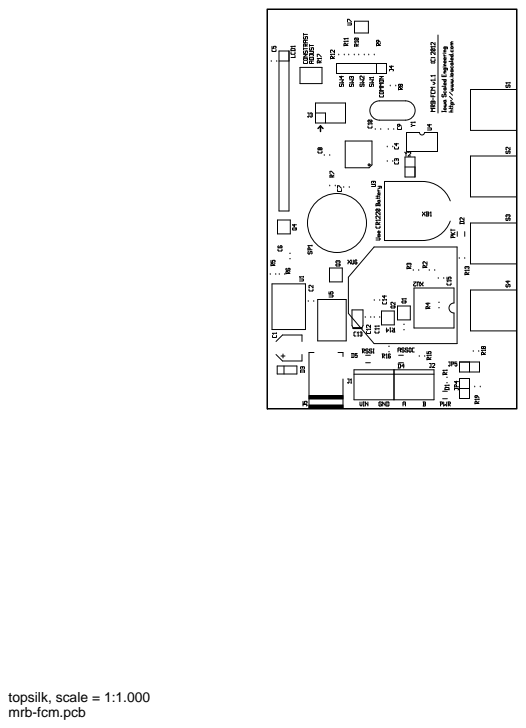
[picture p36: page 7]
topsilk, scale = 1:1.000

bottomsilk (mirrored), scale = 1:1.000

toppaste, scale = 1:1.000

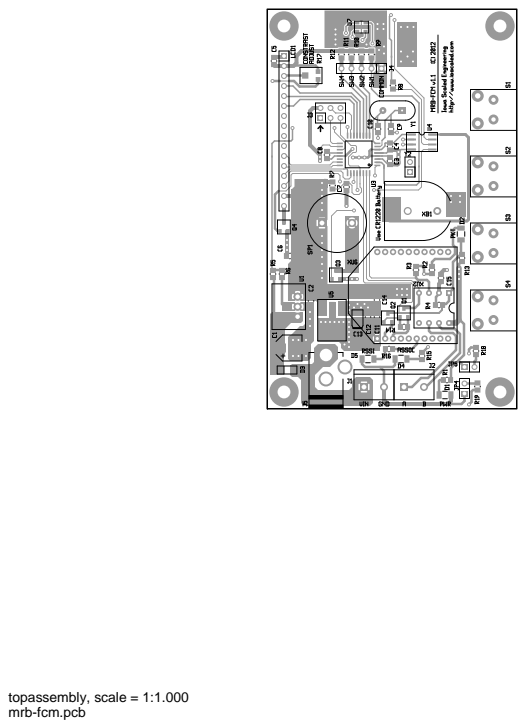
[picture p37: page 10]
topassembly, scale = 1:1.000

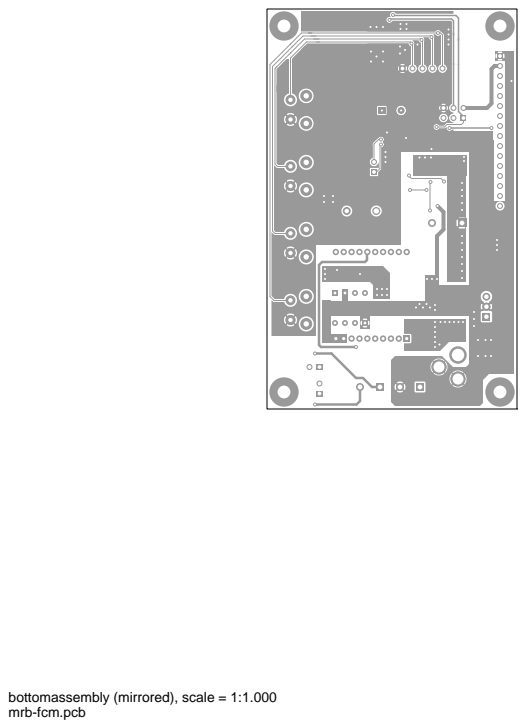
[picture p38: page 11]

bottomassembly (mirrored), scale = 1:1.000

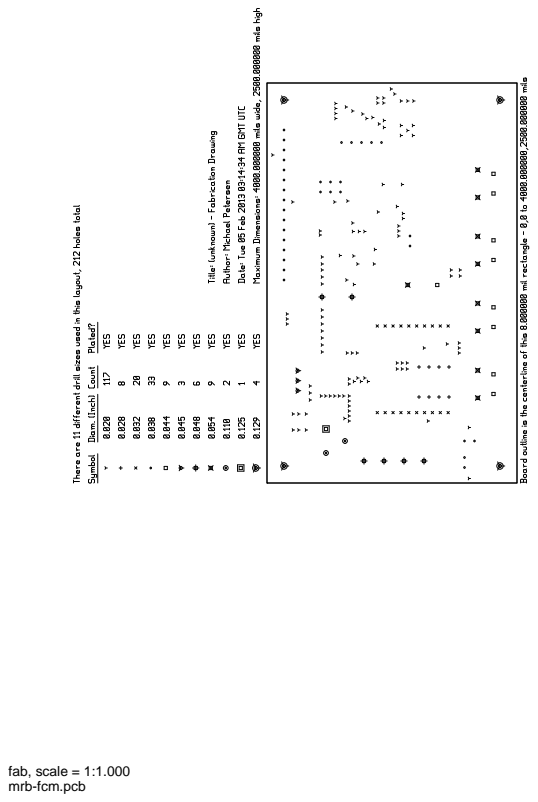
[picture p39: page 12]
fab, scale = 1:1.000
