IowaScaledEngineering/mrb-fcm/pg/mrb-fcm-v1.1-r688/mrb-fcm.pdf

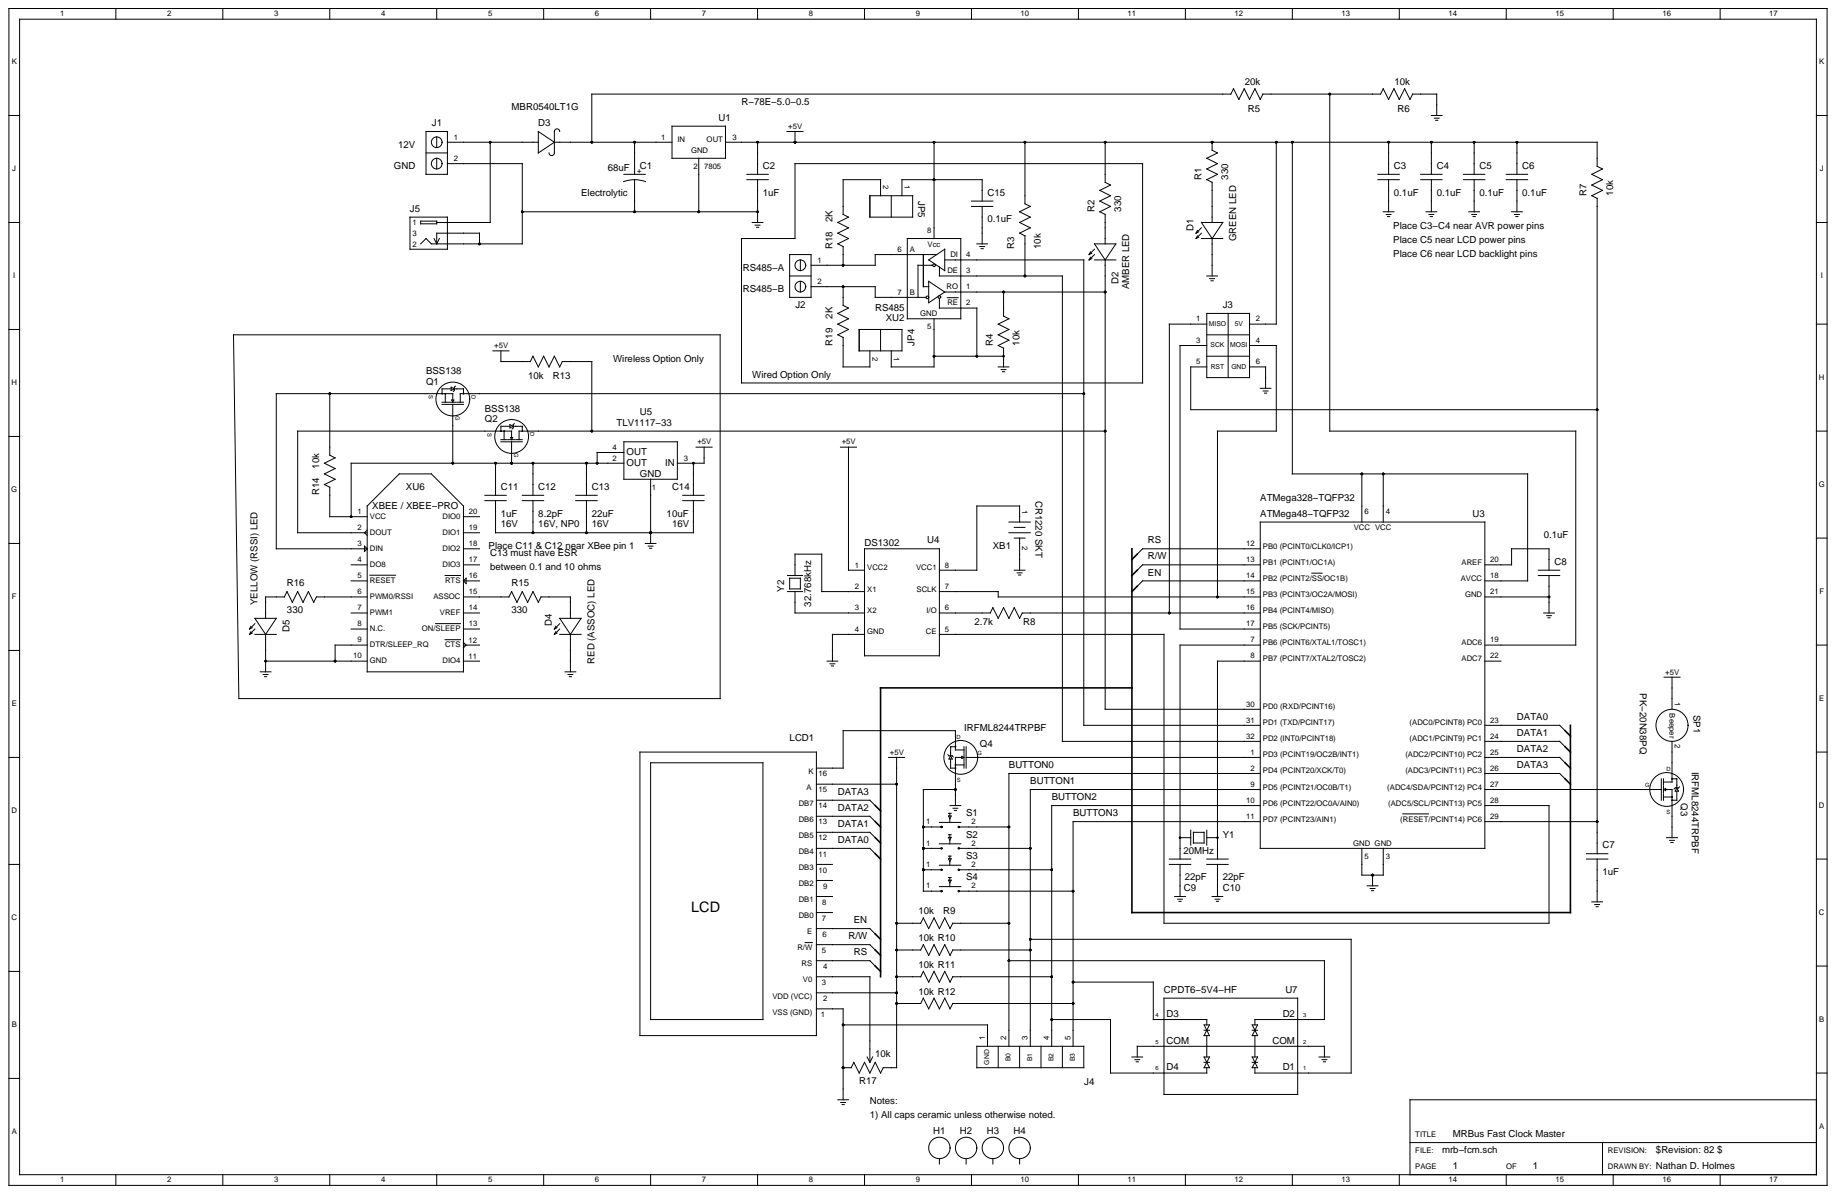
[picture p40: page 1]

D1Place C3−C4 near AVR power pins

Place C5 near LCD power pins

Place C6 near LCD backlight pins 1

2 | GND | 3DE

Notes:
1) All caps ceramic unless otherwise noted.

MRBus Fast Clock Master
mrb−fcm.sch
