IowaScaledEngineering/mrb-fcm/doc/faceplate-dimensions.pdf

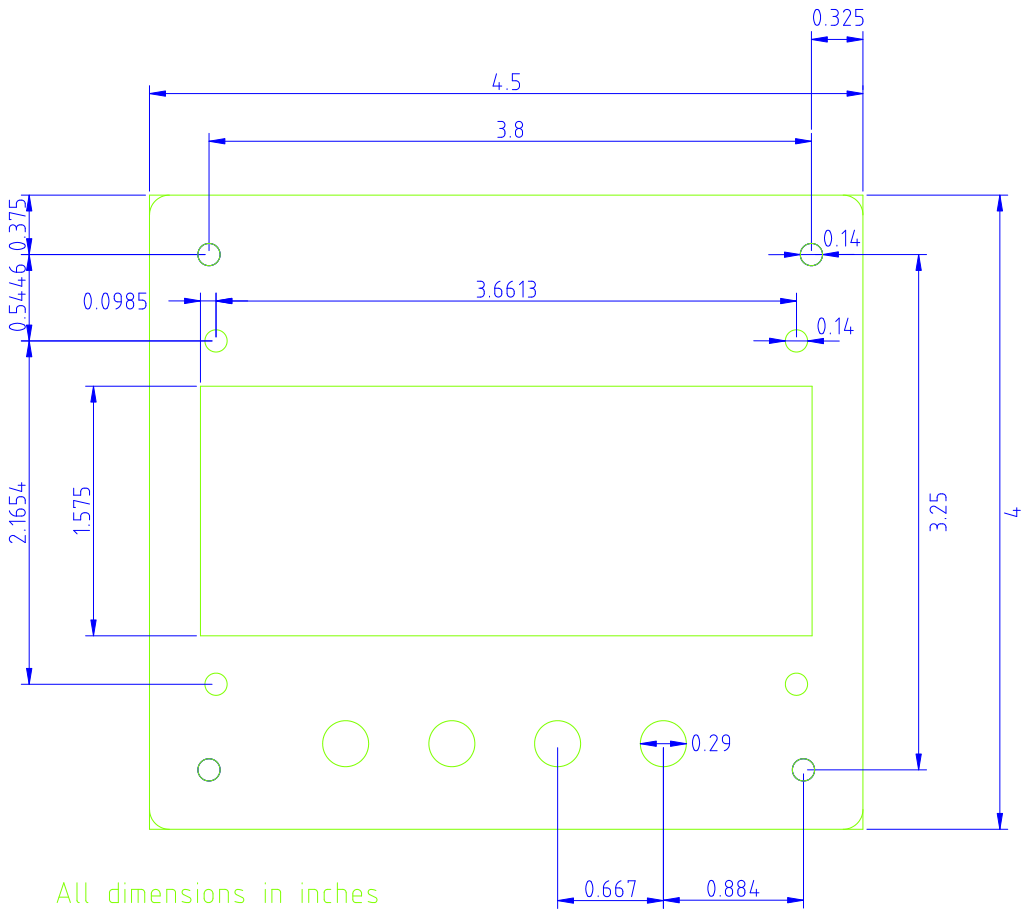
[picture p41: page 1]
