IowaScaledEngineering/mrb-fcm/pg/mrb-fcm-v2.0-2ea09b9/mrb-fcm-pcb.pdf

# mrb-fcm.pcb

# 1. Table of Contents (This Page) Created on Wed Apr 29 11:11:00 2020

# 2. component 3. solder 4. outline 5. plated-drill 6. unplated-drill 7. componentmask 8. soldermask 9. topsilk 10. bottomsilk 11. toppaste 12. topassembly 13. bottomassembly 14. fab

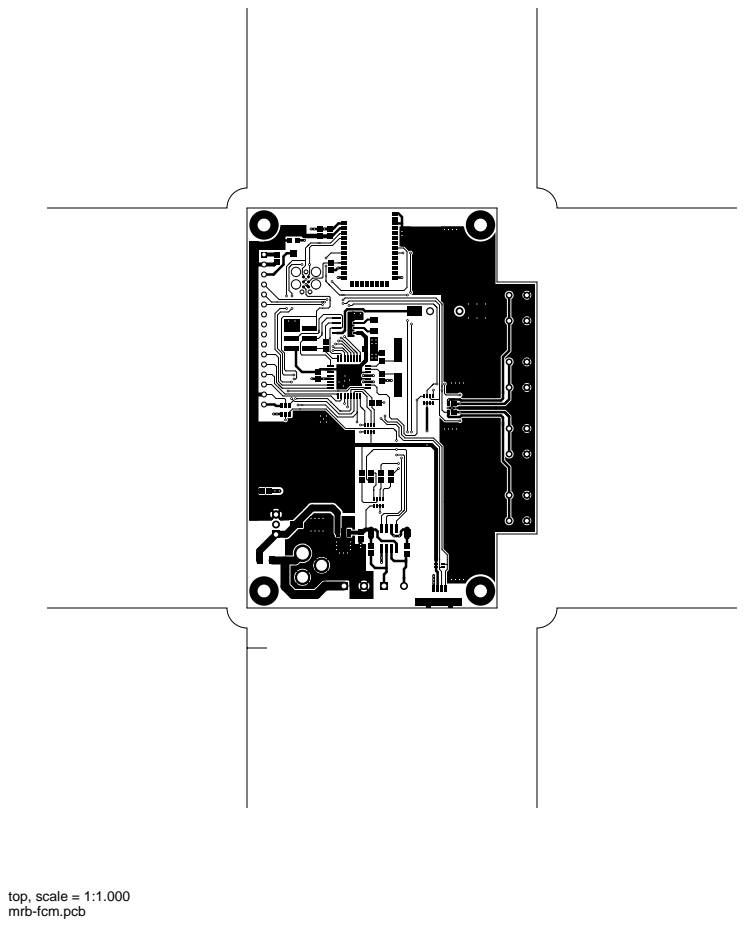
[picture p42: page 2]
top, scale = 1:1.000

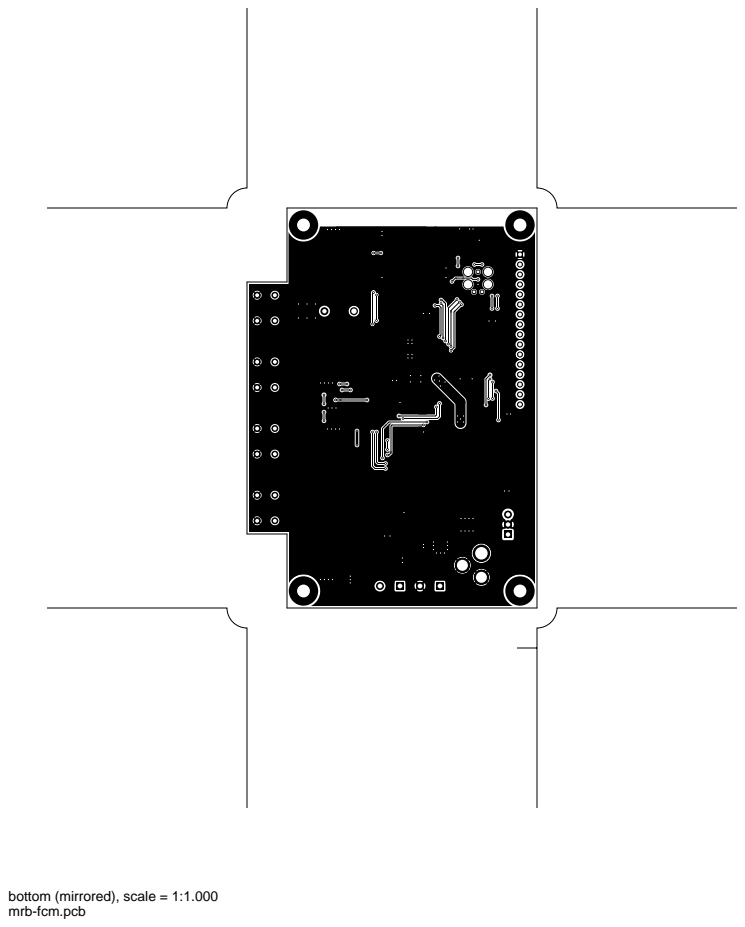
[picture p43: page 3]

bottom (mirrored), scale = 1:1.000

outline, scale = 1:1.000

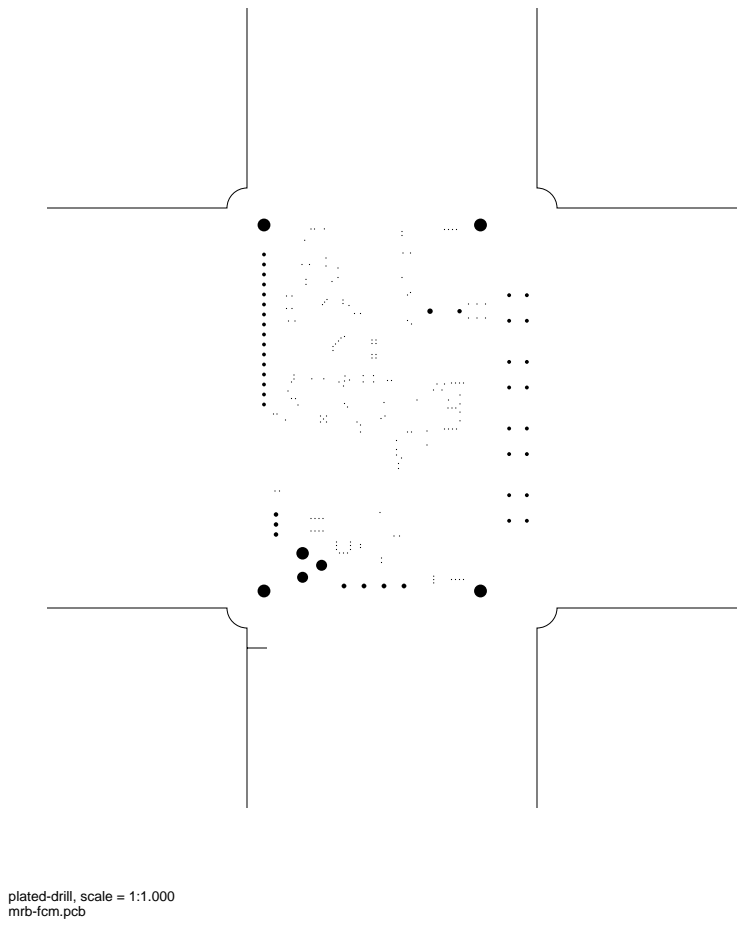
[picture p44: page 5]

plated-drill, scale = 1:1.000

unplated-drill, scale = 1:1.000

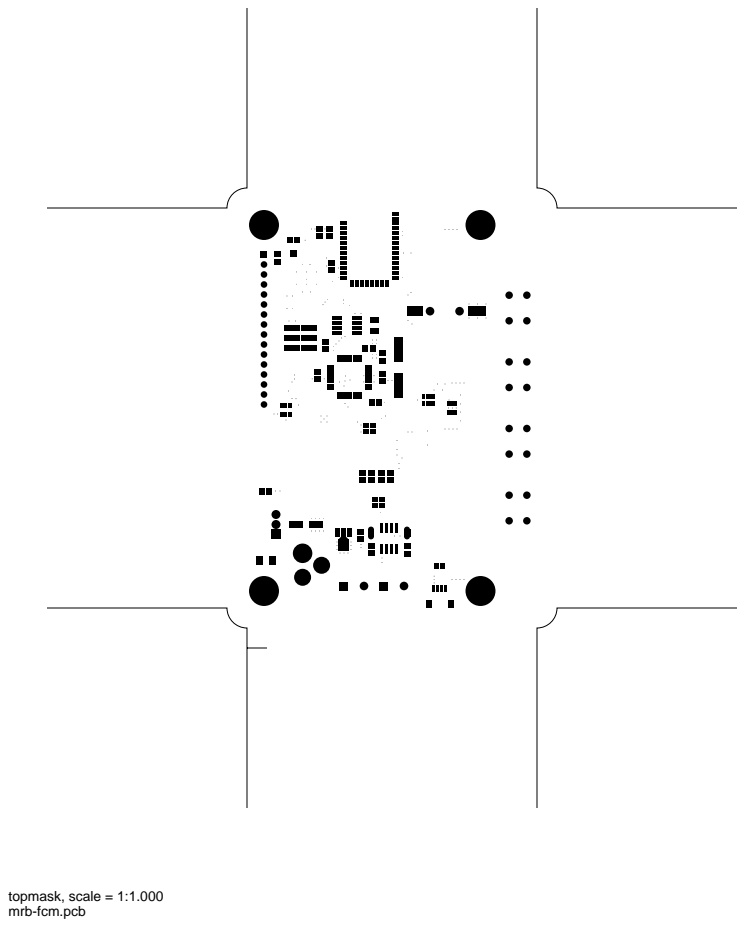
[picture p45: page 7]
topmask, scale = 1:1.000

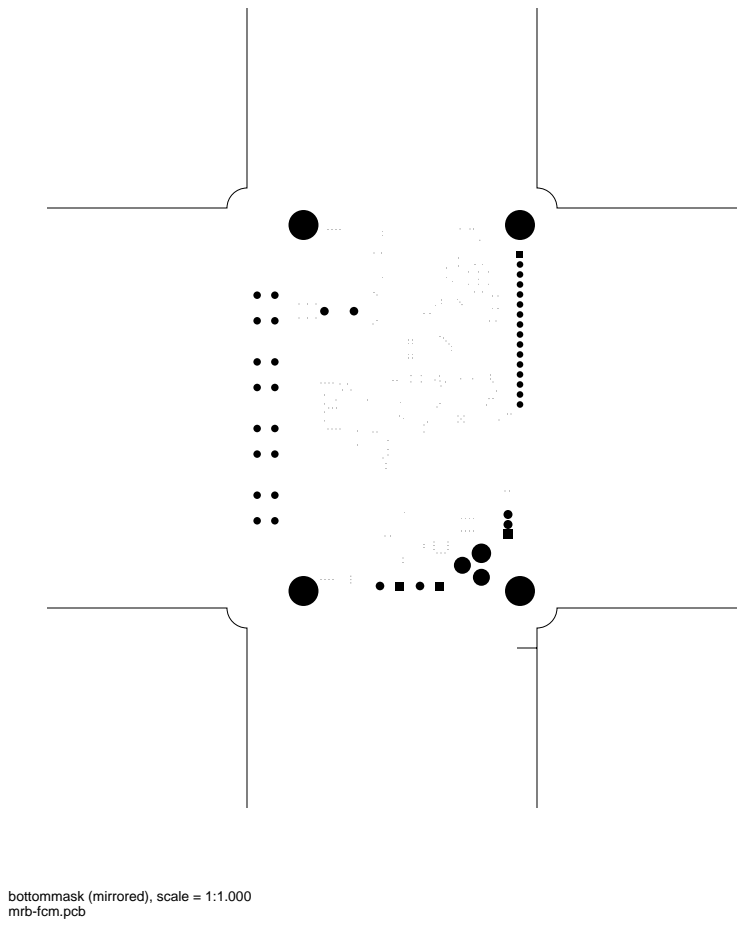
[picture p46: page 8]

bottommask (mirrored), scale = 1:1.000

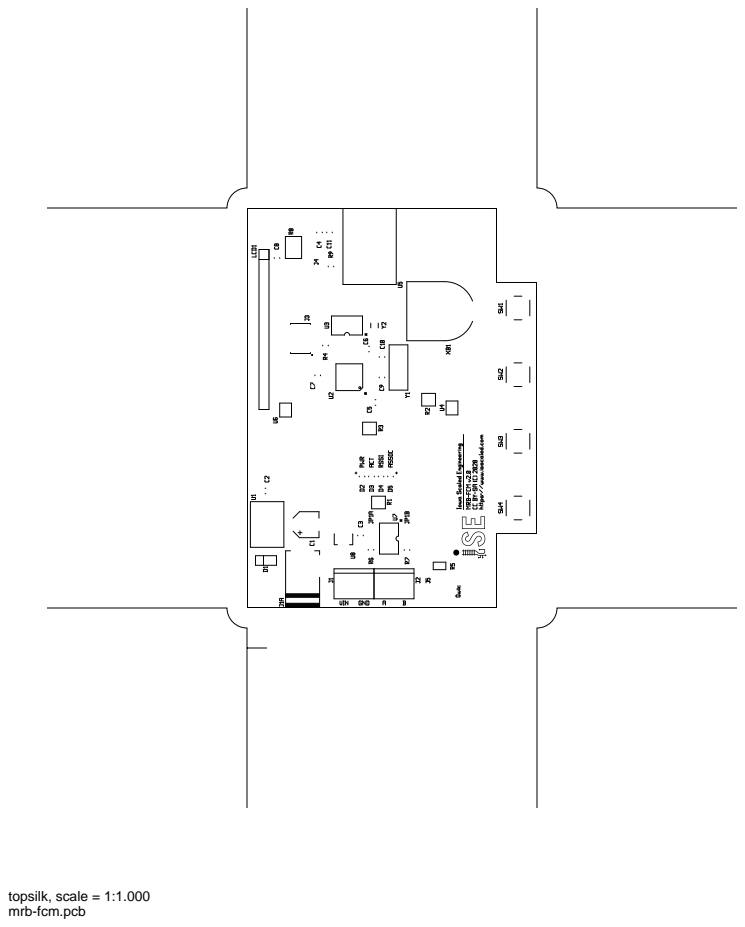
[picture p47: page 9]
topsilk, scale = 1:1.000

bottomsilk (mirrored), scale = 1:1.000

toppaste, scale = 1:1.000

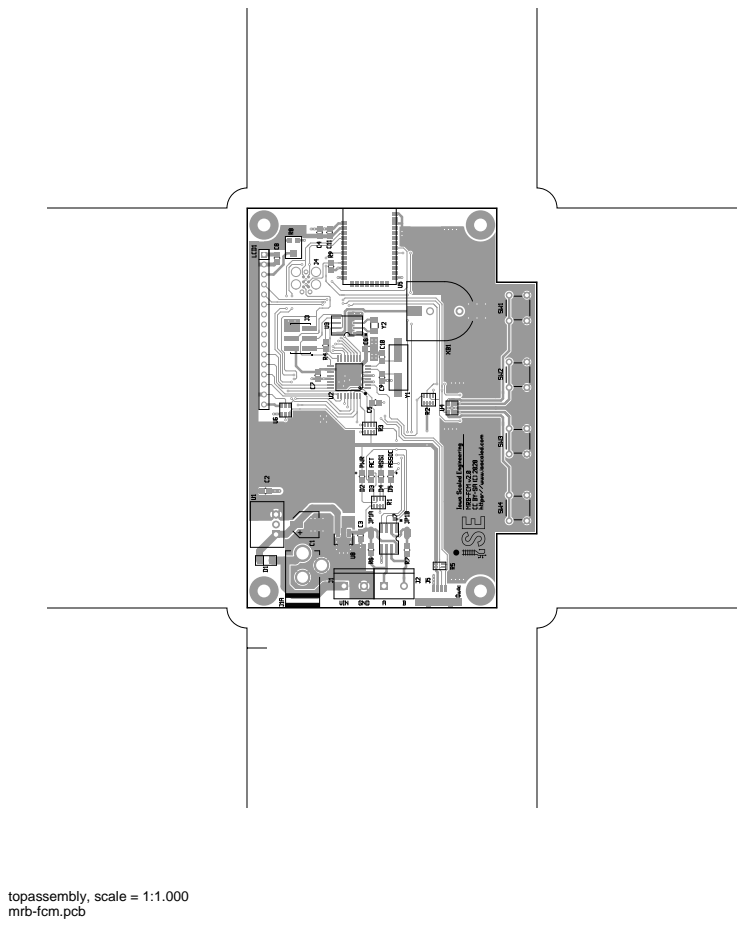
[picture p48: page 12]
topassembly, scale = 1:1.000

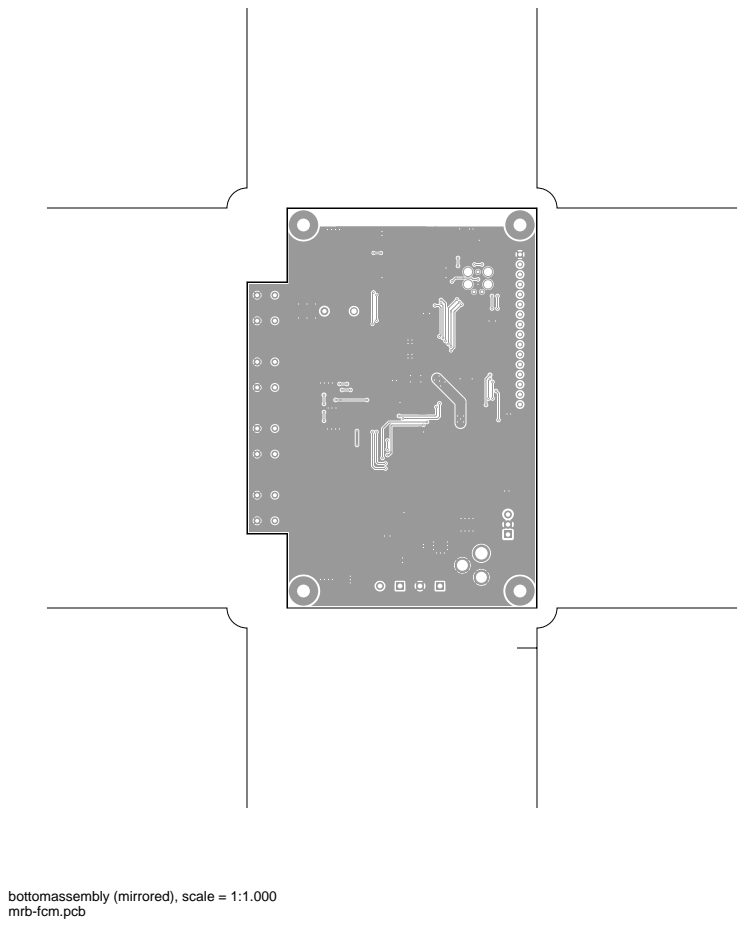
[picture p49: page 13]

bottomassembly (mirrored), scale = 1:1.000

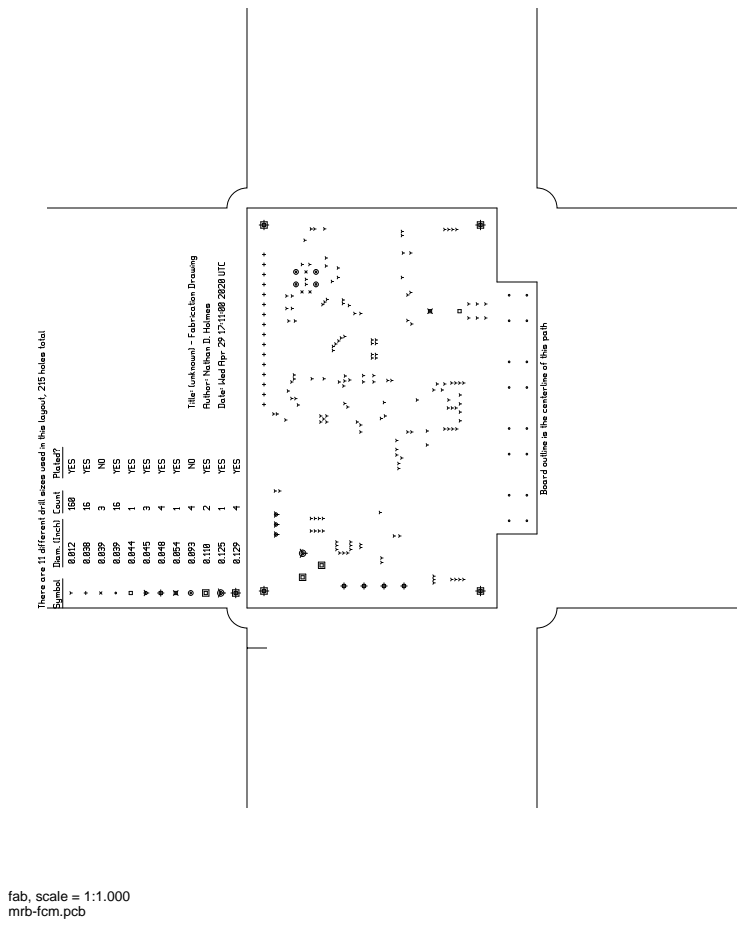
[picture p50: page 14]
fab, scale = 1:1.000
