IowaScaledEngineering/mrb-fcm/pg/1.0/mrb-fcm-pcb.pdf

# mrb-fcm.pcb

# 1. Table of Contents (This Page) Created on Fri Sep 28 15:00:41 2012

# 2. component 3. solder 4. plated-drill 5. componentmask 6. soldermask 7. topsilk 8. bottomsilk 9. toppaste 10. topassembly 11. bottomassembly 12. fab

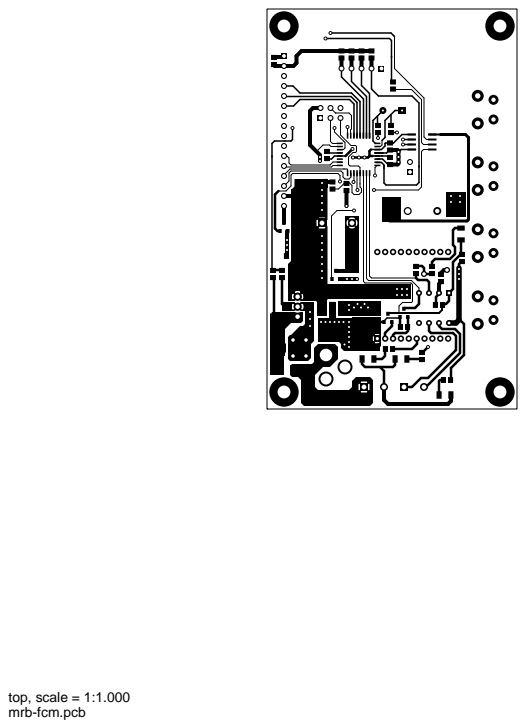
[picture p51: page 2]
top, scale = 1:1.000

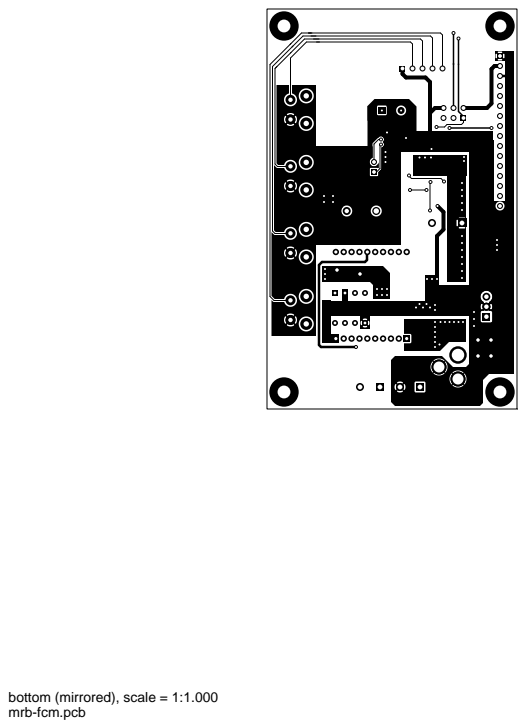
[picture p52: page 3]

bottom (mirrored), scale = 1:1.000

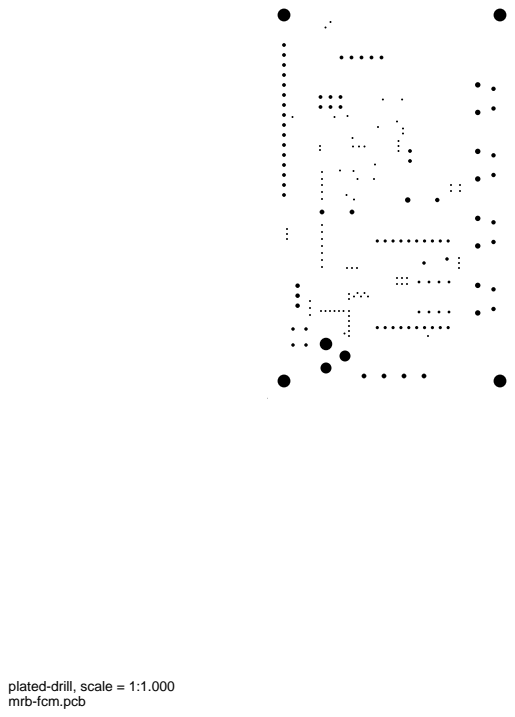
[picture p53: page 4]

plated-drill, scale = 1:1.000

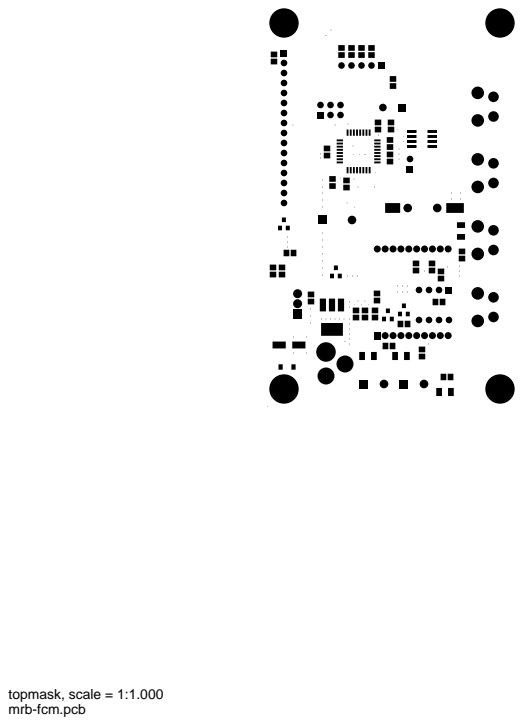
[picture p54: page 5]
topmask, scale = 1:1.000

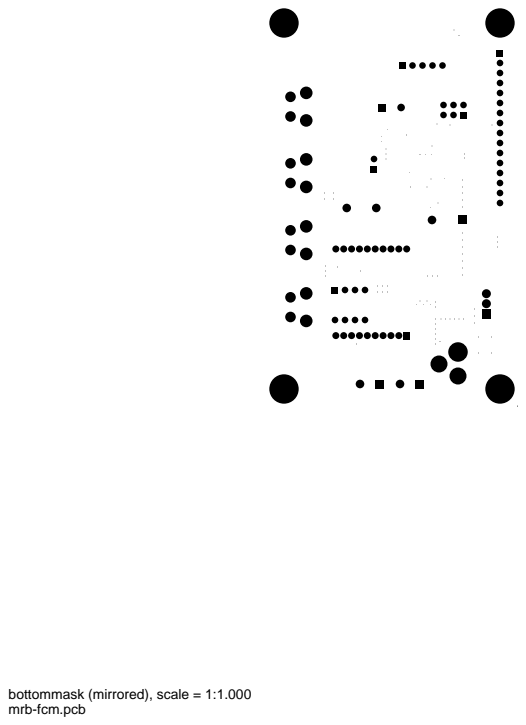
[picture p55: page 6]

bottommask (mirrored), scale = 1:1.000

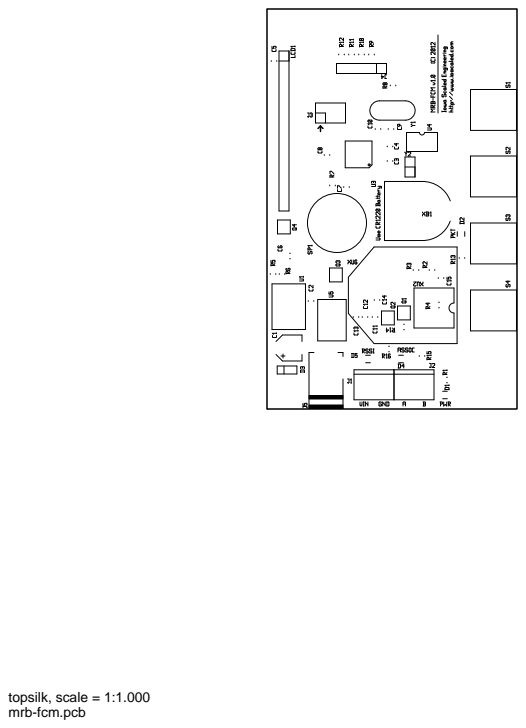
[picture p56: page 7]
topsilk, scale = 1:1.000

bottomsilk (mirrored), scale = 1:1.000

toppaste, scale = 1:1.000

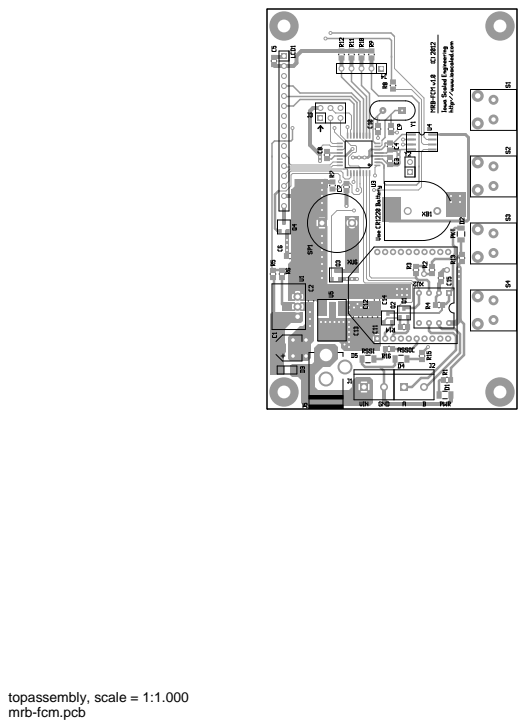
[picture p57: page 10]
topassembly, scale = 1:1.000

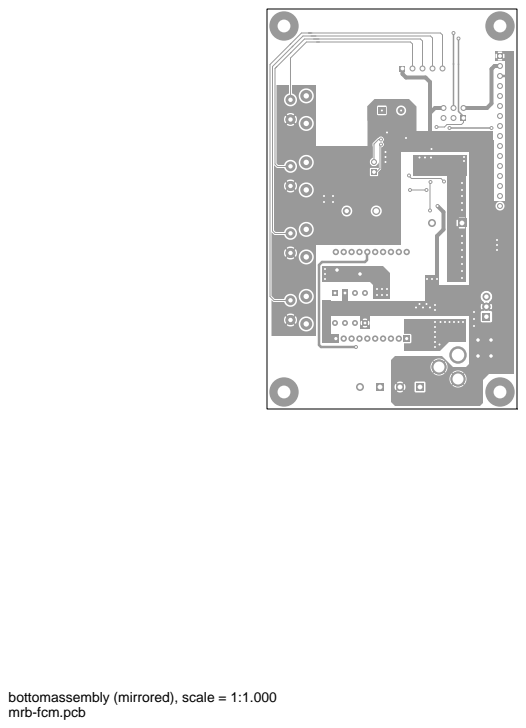
[picture p58: page 11]

bottomassembly (mirrored), scale = 1:1.000

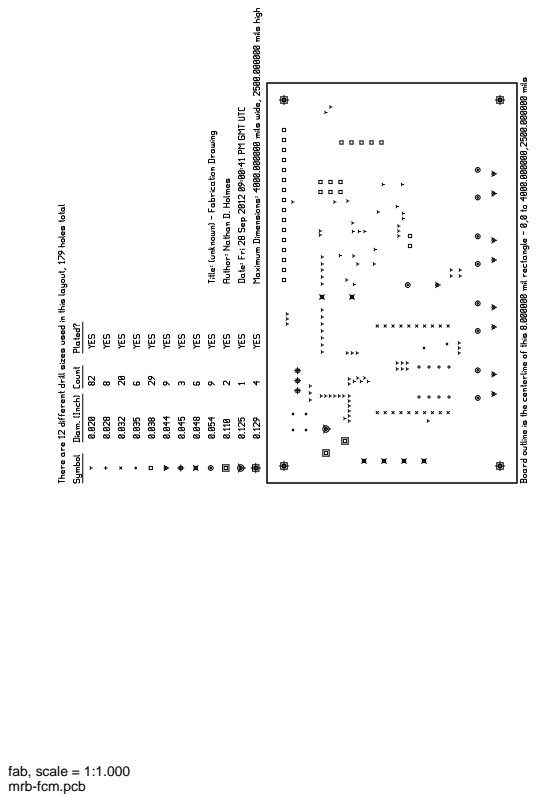
[picture p59: page 12]
fab, scale = 1:1.000
