IowaScaledEngineering/mrb-fcm/(list of files, drawings)

Other design files:
pcb/mrb-fcm-sw.pcb
pcb/mrb-fcm.pcb
