IowaScaledEngineering/mrb-fcm/doc/xbee/verify.py

import serial
import time
import argparse
import sys

def xbeeParam(param, expectedValue):
	ser.write(param + ",")
	read_val = ser.read(size=64).rstrip()
	sys.stdout.write(param + "=" + read_val)
	if(expectedValue == int(read_val,16)):   # ID requires hex, use hex for all to make things simple
		sys.stdout.write(" OK\n")
	else:
		sys.stdout.write(" Fail!\n")

parser = argparse.ArgumentParser()
parser.add_argument('port')
parser.add_argument('baud')
args = parser.parse_args()

try:
	ser = serial.Serial(args.port, args.baud, timeout=0.1)
	ser.close()
	ser.open()
	sys.stdout.write("Entering command mode... ")
	time.sleep(1)
	ser.write("+++")
	time.sleep(1)
	read_val = ser.read(size=64).rstrip()
	sys.stdout.write(read_val + "" + "\n")

	print "Reading..."
	ser.write("AT")

	xbeeParam("ID", 0x225)
	xbeeParam("RR", 6)
	xbeeParam("RN", 3)
	xbeeParam("PL", 4)
        xbeeParam("PP", 19)
	xbeeParam("SM", 0)
	xbeeParam("BD", 7)
	xbeeParam("AP", 2)

except serial.SerialException:
	print "Error opening serial port"
