IowaScaledEngineering/mrb-fcm/(commit log)

2012-07-30 Changes for today - now seems to mostly work (except date stuff, and doesn't transmit a packet yet)
    [mrb-fcm.c]
2012-08-22 Fast clock master schematic work
    [mrb-fcm.sch]
2012-08-24 Update to add wireless bits for fun
    [mrb-fcm.sch]
2012-08-24 Changed to a linreg on the 3.3V
    [mrb-fcm.sch]
2012-08-24 Centered things so it wasn't so lopsided
    [mrb-fcm.sch]
2012-09-15 Fixed RX/TX on the wireless, added control fet for backlight, and added buzzer output
    [mrb-fcm.sch]
2012-09-16 Changes to the FCM and initial PCB
    [mrb-fcm.pcb, mrb-fcm.sch]
2012-09-17 Updated to fix Michael's pestering and to add switches
    [mrb-fcm.pcb]
2012-09-17 Added switches
    [mrb-fcm.sch]
2012-09-28 Michael's suggestions applied, round 2
    [mrb-fcm.pcb]
2012-09-28 First production cut of the board, as uploaded to BPCB
2012-11-05 This won't compile, but it's all I've done today. Will fix later
    [mrb-fcm.c]
2012-11-07 Well, it compiles, it just doesn't work
    [mrb-fcm.c]
2012-11-08 Added contract potentiometer
    [mrb-fcm.sch]
2012-11-09 Fixes and changes from Michael and Joe
    [mrb-fcm.c]
2012-11-10 Bugfixes from today's code changes
    [mrb-fcm.c]
2012-11-21 Fix little time/date not overwriting first date digit problem Add support for a TH node
    [mrb-fcm.c]
2012-11-26 Added fixes for temp/hum stuff
    [mrb-fcm.c]
2012-11-26 Changes and fixes to add timeout configuration to menu
    [mrb-fcm.c]
2012-11-27 Added TH voltage to diag screen Fixed some menu screen reference issues
2012-12-03 Rev to 1.1 - added contrast pot and bus bias jumpers
    [mrb-fcm.pcb, mrb-fcm.sch]
2012-12-05 Changes to: - Add bias resistors - Add contrast pot - Add ESD diodes - Connect Xbee sleep rq line to ground - Change out ceramic C13 for tantalum
    [mrb-fcm.pcb, mrb-fcm.sch]
2012-12-05 Changes to add the tantalum to the w-fcs and ground the sleep req pin A few cleanup items on the fcm
    [mrb-fcm.pcb]
2012-12-06 More ground plane!
    [mrb-fcm.pcb]
2013-01-03 Fixed silkscreen on holes and TQFP32. Schematic now references TQFP32 footprint (not _7)
    [mrb-fcm.pcb, mrb-fcm.sch]
2013-01-03 Fixed footprint name
    [mrb-fcm.pcb]
2013-02-03 Moved silk outline to be within boundary. LVS/DRC Clean.
    [mrb-fcm.pcb]
2013-02-03 Added PG files.
    [mrb-fcm.bottom.gbr, mrb-fcm.bottommask.gbr, mrb-fcm.fab.gbr, mrb-fcm.top.gbr, mrb-fcm.topmask.gbr, mrb-fcm.toppaste.gbr, mrb-fcm.topsilk.gbr]
2013-02-05 Changed large (60/35) vias to standard (40/20) vias to make freedfm happy. Added additional set under C1.
    [mrb-fcm.pcb]
2013-02-05 LVS/DRC Clean.
    [mrb-fcm.pcb]
2013-02-05 New PG.
    [mrb-fcm.bottom.gbr, mrb-fcm.bottommask.gbr, mrb-fcm.bottompaste.gbr, mrb-fcm.bottomsilk.gbr, mrb-fcm.fab.gbr, mrb-fcm.outline.gbr, mrb-fcm.top.gbr, mrb-fcm.topmask.gbr]
2013-02-11 Fixes for the cpdt symbol and schematic to move/fix the device identifier
    [mrb-fcm.sch]
2013-03-09 Initial version
    [fcm-box.scad]
2013-03-09 Increased to 4.5x4.5
    [fcm-box.scad]
2013-03-09 Added open-frame version
    [fcm-box-open.scad]
2013-11-04 Added support files
    [fcm-box-open-repaired.stl, fcm-box-open.stl, fcm-box.stl]
2014-01-10 Add dxf version of faceplate
    [Display.dxf]
2014-01-10 Add faceplate drawing with dimensions
    [Display-Dimensions.dxf]
2014-05-20 Added switch board.
    [mrb-fcm-sw.pcb]
2014-05-26 Added bottom silk
    [mrb-fcm-sw.pcb]
2014-07-09 Add PG data for fast clock sw board
    [mrb-fcm-sw.bottom.gbr, mrb-fcm-sw.bottommask.gbr, mrb-fcm-sw.bottompaste.gbr, mrb-fcm-sw.bottomsilk.gbr, mrb-fcm-sw.fab.gbr, mrb-fcm-sw.outline.gbr, mrb-fcm-sw.top.gbr, mrb-fcm-sw.topmask.gbr]
2014-08-01 Increase screw hole sizes to 0.148" to provide clearance for a #6 screw
2019-03-28 v1 files exported from F360
    [FCM Faceplate.f3d, FCM Faceplate.stl]
2020-04-17 First draft of the "v2" clock - not the true next gen, but an improvement on the current AVR-based clock
    [mrb-fcm.sch]
2020-04-17 Fix PCB base hole spacing and LCD header to exactly match LCD data sheets
    [mrb-fcm.pcb, mrb-fcm.sch]
2020-04-17 Fix path to ise-footprints
2020-04-20 Initial cut of v2 PCB
    [mrb-fcm.pcb, mrb-fcm.sch]
2020-04-20 Remove comment from old R3A.
    [mrb-fcm.sch]
2020-04-21 Fix stuff
    [mrb-fcm.pcb, mrb-fcm.sch]
2020-04-21 Fix switch text
    [mrb-fcm.pcb]
2020-04-28 Add ISE logo
    [mrb-fcm.pcb]
2020-04-28 PG v2 of the fast clock master
    [mrb-fcm.bottom.gbr, mrb-fcm.bottommask.gbr, mrb-fcm.bottompaste.gbr, mrb-fcm.bottomsilk.gbr, mrb-fcm.fab.gbr, mrb-fcm.outline.gbr, mrb-fcm.top.gbr, mrb-fcm.topmask.gbr]
2020-04-29 Fix issue where DMN5L06 symbol was bad
    [mrb-fcm.pcb, mrb-fcm.sch]
2020-04-29 Remove initial v2 pg - bad DMN
    [mrb-fcm.bottom.gbr, mrb-fcm.bottommask.gbr, mrb-fcm.bottompaste.gbr, mrb-fcm.bottomsilk.gbr, mrb-fcm.fab.gbr, mrb-fcm.outline.gbr, mrb-fcm.top.gbr, mrb-fcm.topmask.gbr]
2020-04-29 Add fixed v2 pg
    [mrb-fcm.bottom.gbr, mrb-fcm.bottommask.gbr, mrb-fcm.bottompaste.gbr, mrb-fcm.bottomsilk.gbr, mrb-fcm.fab.gbr, mrb-fcm.outline.gbr, mrb-fcm.top.gbr, mrb-fcm.topmask.gbr]
2020-05-27 Backed up v1 faceplate files
    [Display-Dimensions.dxf, Display.dxf, FCM Faceplate.f3d, FCM Faceplate.stl]
2020-06-03 Draft of mega1284-based master
    [mrb-fcm.sch]
2020-06-06 More modifications to the clock master
    [mrb-fcm.sch]
2020-06-06 Change crystal to 4-pin job for space reasons
    [mrb-fcm.sch]
2020-06-07 v2.1 initial commit
    [mrb-fcm.pcb, mrb-fcm.sch]
2020-06-10 Fixes from review
    [mrb-fcm.pcb, mrb-fcm.sch]
2020-06-13 Fixed text alignment
    [mrb-fcm.sch]
2020-06-22 Fix boost capacitor to 0.1uF, not 0.01uF
    [mrb-fcm.sch]
2020-07-02 PG v2.1
    [mrb-fcm.bottom.gbr, mrb-fcm.bottommask.gbr, mrb-fcm.bottompaste.gbr, mrb-fcm.bottomsilk.gbr, mrb-fcm.fab.gbr, mrb-fcm.outline.gbr, mrb-fcm.top.gbr, mrb-fcm.topmask.gbr]
2020-07-12 Remove DS1302 driver
2020-07-18 Initial cut of firmware for v2 hardware
2020-07-19 Enable f_XXX string functions in the library Comment out the sample file write
2020-07-26 Faceplate for v2
    [fcm-faceplate v5.stl]
2020-09-20 Add code to save fast time to the 3129's user ram so that it comes back on startup Added bits to the Makefile to allow for wired compilation
2020-09-30 Fix pin 1 mark for voltage regulator
    [mrb-fcm.pcb]
2020-11-19 Updated mechanical files
    [fcm-faceplate v5.stl, fcm-faceplate v8.stl, fcm-spacer v3.stl]
2020-11-19 Fixed some issues on volatile variables and other such - simplified variables going in and out of the ISR
    [mrb-fcm.c]
2020-11-19 Add factor reset code
    [mrb-fcm.c]
2020-11-19 Updates to create a diagnostic screen, fix new 16-bit input switch var, and display accurate software versions
    [mrb-fcm.c]
2021-07-08 Fix issues with slow time Add proper TH v3 support
    [mrb-fcm.c]
2021-07-08 Fix issue where the SPI module was messing with PB4
    [mmc-avr.c, mrb-fcm.c]
2021-07-20 Add some lcd_clrscr()s and fix an error where I was calling lcd_puts with a PSTR in real date setting
    [mrb-fcm.c]
2021-07-27 Box for sitting on table
    [fcm-table-mount v6.stl]
2021-11-19 New faceplate files
    [fcm-faceplate v11.stl, fcm-faceplate v8.stl]
2022-07-12 Updated skirt and changed from "Prusament PETG" to "Generic PETG" (cooler temperature, less strings)
2026-06-20 New spacers
    [fcm-faceplate2-spacer.stl, fcm-spacer2.stl]
